snsnnd/li_ku/model/Belt_1Cell_MVP_E02/README.md

# E02 — XY同步带＋Z金属丝杆的单库位机械MVP

**使用现有3台ZDT；目标货载1kg。取消XY齿条，固定X电机，将Y电机从推拉头移到Z平台，保留金属TR8x2和金属导向。**

## 打开文件

- **[优先打开：完整纯实体兼容STEP](viewing/Belt_MVP_E02_SOLIDS_AP203.step)**，AP203、多实体零件，无运动配合。
- [彩色装配STEP](Belt_MVP_E02_ASSEMBLY.step)。若导入空白，改用上面的纯实体版；SolidWorks可按F和Ctrl+7。未在用户CAD界面中验证显示。
- [工程图PDF](drawings/同步带单库位MVP_E02_工程图.pdf)、[总装预览](previews/E02_assembly.png)、[移动结构近览](previews/E02_moving_structure.png)。预览省略保护板，完整STEP保留。
- [优化前后对比](E01_E02优化对比.md)、[打印清单](打印清单.csv)、[采购与金属加工清单](采购与金属加工清单.csv)、[采购补充与未选型项](采购补充与未选型项.md)。
- [机械设计包ZIP](同步带单库位MVP_E02_机械设计包.zip)、[交付审核](delivery_audit.json)。

## 已优化的结构

| 项目 | E02 |
|---|---|
| X | 固定电机；GT2-1000-6、20T金属带轮；不再拖动电机，移动板深度160→120 |
| Y | GT2-400-6；电机固定Z平台下方，侧置皮带，推拉头只有轻连接臂和带夹 |
| Y导向 | 双轨中心距26→52mm；局部降低6mm，皮带避开完整滑块包络及存取通道 |
| 张紧 | X向右、Y向后调整；金属带夹、带轴承惰轮及独立锁紧螺钉 |
| 承力 | 金属方管/压缩套/垫块/支板，Z金属丝杆及双螺母保持 |
| 体积 | 底板610×650→610×590×6；约616×596×523的防护外廓 |
| 功能尺寸 | X180、Z95、Y143；一货位＋独立IO＋一只原尺寸料盒 |

本版独立输出，**不覆盖E01、V03.1或手动M01**。B编号是本版分件编号，不能与E01的E编号混用。

## 1kg是不是轻载？

**就货物本身而言，是轻载。** 但它只表示货物净重；Z还要搬动托盘、导向平台、电机、释放机构和料盒。完整运动质量与扭矩估算见优化对比，不能将电机只按9.8N货物重力选型。托盘悬臂、摩擦、加减速和异常掉落也需考虑。

优化目标是减少无效移动质量、悬臂和齿条调试难度，不是把1kg包装成已验收载荷；也没有擅自提高目标承重。

货物竖向重量主要由托盘/金属方管及Z升降结构承受；Y同步带和轻连接臂负责推拉，不是把整个货物悬挂在薄连接臂上。

## 打印/采购边界

- 只打印`stl/`中`process=print`对应分件，按CSV数量；不要把整机一次打印。
- 带轮、惰轮轴承/肩轴、带夹、承力板、方管、丝杆、螺母桥和维护件必须是合适金属件，不能打印替代。
- 采购带轮/同步带是光滑有效包络，夹齿只示意节距。**它们不是GT2制造齿形，也不是已经选定供应商的产品。**
- 张紧器±/单向2mm是调整空间，不是要求把皮带拉长4mm。15N预紧只是估算例，不能作为操作张力。
- 采购BOM记录CAD实例数量，全部型材角码、PC门板保持、线束和非建模连接五金仍需补选。补充清单列出具体边界。
- 图纸是设计评审图，未完成公差、实际螺纹、厂商尺寸、有效啮合、工具可达性和工艺签审，不能直接视为加工放行图。

## 仍不能直接上电带载

同步带降低所需驱动扭矩，但张紧会增加电机轴的径向力，必须核对实际ZDT轴承/轴端能力。还需确认：

1. 实测电机质量、扭矩-转速曲线、电压/电流和温升；真实驱动带轮夹紧及轴向保持。
2. 实带规格/齿形/张力、金属带夹拉脱、惰轮轴承/肩轴、张紧锁紧、板件刚度和线束全行程。
3. 丝杆/螺母/轴承配合、预紧、横销定位套强度和寿命；全部紧固、压缩套和台面锚固。
4. **独立自动防下滑装置、实际限位/门禁/急停和电气保护，仍未完成选型/实施。** 第二螺母、低导程丝杆和手动维护销不能替代自动防坠。
5. 自动存取固件未提供；释放舵机、IO门和传感器仍需实际选型与接入。

模型维护销默认插入。Z运动前必须可靠卸载、拔销并确认状态。先完成安全措施，再组织空行程/空盒及分级加载试验；**目标1kg不等于允许直接1kg带载运行**。

## 复现

使用`cad/powered_mvp/requirements.lock.txt`中的环境；需保留归档内E01基准分件与源代码。另需可嵌入的中文字体（工具默认本机Windows SimHei）和DejaVu Sans。

```sh
python -B cad/belt_mvp/validate_belt.py --motion --export
python -B cad/belt_mvp/deliver_belt.py
PYTEST_DISABLE_PLUGIN_AUTOLOAD=1 python -B -m pytest cad/belt_mvp/test_belt.py -q -p no:cacheprovider --junitxml=model/Belt_1Cell_MVP_E02/tests.xml
python -B cad/belt_mvp/publish_belt.py
```
