snsnnd/li_ku/V03_1_先读我.md

# V03.1：承重路径与移动机构优化

**保留原 V03，独立输出到 `model/V03_1/`。这是结构优化原型，不是已经验收的整机。**

## 打开模型

- **[优先打开：轻量布局 STEP](model/V03_1/viewing/ASRS_V03_1_LIGHT_VIEW.step)**：省略防护板，简化电机和小齿轮，仅用于查看布局，不能加工或打印。
- [完整装配 STEP](model/V03_1/ASRS_Modular_V03_1.step)
- [完整细节内部结构 STEP](model/V03_1/viewing/ASRS_V03_1_INTERIOR_VIEW.step)：仅去掉防护板，仍是大文件。
- [整机预览](model/V03_1/previews/assembly_isometric.png)
- [移动模块](model/V03_1/previews/moving_module.png)
- [X 齿条支撑](model/V03_1/previews/x_rack_supports.png)
- [Z 齿条加强结构](model/V03_1/previews/z_rack_supports.png)
- [Y 取放与电源布置](model/V03_1/previews/y_module.png)
- [IO 承重结构](model/V03_1/previews/io_station.png)

轻量版和预览隐藏防护板不代表运行时可以拆除防护。橙色部件表示未选型硬件，不能照包络采购。

## 这次实际改了什么

1. **X 齿条不再悬空**：增加 7 个金属 L 形支脚，齿条背板经 M4 接支脚，支脚经 M5 接底板；接收底孔一并建模。
2. **Y 齿条补齐支撑**：将原来相隔 6 mm 的支撑块改成组合鞍座，同时连接金属脊板、承托方管和齿条背板，具有实际贴合面及配对孔位。
3. **IO 支腿落到底板**：改为带底法兰的金属支腿；顶部金属框架、料盒托板和支腿孔位对应，补齐原来 20 mm 的悬空段。
4. **Z 齿条背板加强**：铝背板由 4 mm 增至 12 mm，支撑由 2 处增至 5 处，最大支撑间距由约 525 mm 缩至 135 mm；齿条安装面、节距和啮合相位不变。
5. **减轻 Y 滑台偏载**：Y 独立电源盒移到 Z 升降平台，用本地柔性短线接 Y 电机；不再随 Y 伸缩。取放头悬臂末端由 X+256 收至 X+120，移除随 Y 的电池支腿。
6. **增加检查项**：除碰撞外，检查新增/修改接口的间隙和真实贴合面积；零件只共享一条边不算支撑。补充紧固孔和螺纹周围金属连续性回归。

料盒、20 个库位、独立 IO 位置、三轴齿条参数和真实电机模型保持原方案。

## 最终核验结果

- 34 项回归测试通过，包括真实齿形/拼接、运动相位及新增孔位检查。
- 新增/修改的 42 处接口通过名义间隙与真实贴合面积检查。
- 1097 个离散运动位姿未发现意外干涉，覆盖 20 个库位及 IO。
- 127 类零件、376 个组件；完整 STEP 回读 445 个有效实体，24 类打印 STL 通过网格检查。
- 最终文件核验错误列表为空，原 V03 CAD 的哈希未改变。

以上只表示本版几何和文件检查通过，不是实物承载、连续碰撞或运行安全认证。

## 优化收益和代价

按现有候选件质量假设，Y 刚性运动组从约 **2.05 kg 降至 1.00 kg**，绕导向中心的偏载力矩从约 **2.47 N·m 降至 0.73 N·m**，降低约 **70%**。这些数值不包含同组之外的货载，不是实测重量，也不代表导轨或螺钉已经通过承载验收。

增加支撑会增加固定结构重量；整机仍约 **68 kg 空机、90 kg 满载含余量**，不是轻量化桌面产品。最新值见 [质量与初筛报告](model/V03_1/engineering_checks.json)。

**Y 盒改挂 Z 的代价是增加一段随 Y 弯曲的本地线束。** 143 mm 行程的线束弯曲半径、应力释放和耐久尚未验证；不能把无线控制理解为没有线，也不能把未建模的柔性线束算入碰撞通过项。

## 当前仍不能放行的部分

- **Z 打印齿的承载、疲劳及蠕变未验收**。背板加强不等于齿强度合格；不能直接带 1 kg 自动运行，空载也必须先完成防坠。
- 独立防坠器/制动器仍为候选包络，没有实测动态捕获证据。
- 三轴电机曲线、减速器、金属夹紧轮毂、输出轴支承与轴向锁定仍需真实选型。**当前法兰轮毂模型不能直接当成完整夹紧轮毂制造。**
- 新增配对孔不等于已经完成螺钉长度、扭矩、工具空间及接头强度定型；T 型螺母必须匹配实际型材。
- 工作台、锚栓、安全门、限位、急停、供电和控制实机验收尚未完成。

**所有制造/硬件放行标志仍为 false。可做受控的局部手动试装，不应直接批量制造或通电带载。**

详见 [结构修改与验收说明](文档/V03_1_结构优化与验证.md)、[新增接口及运动检查](model/V03_1/validation.json)、[最终文件核验](model/V03_1/delivery_audit.json)。
