snsnnd/li_ku/同步带优化MVP_E02_先读我.md

# E02 同步带结构优化版

**三台现有ZDT；XY同步带，Z金属TR8x2；目标1kg货载保持不变。**

- **[优先打开完整兼容STEP](model/Belt_1Cell_MVP_E02/viewing/Belt_MVP_E02_SOLIDS_AP203.step)**
- [工程图PDF](model/Belt_1Cell_MVP_E02/drawings/同步带单库位MVP_E02_工程图.pdf)
- [结构预览](model/Belt_1Cell_MVP_E02/previews/E02_assembly.png)
- [E01→E02优化对比](model/Belt_1Cell_MVP_E02/E01_E02优化对比.md)
- [完整机械设计包ZIP](model/Belt_1Cell_MVP_E02/同步带单库位MVP_E02_机械设计包.zip)
- [打印、采购及安全边界](model/Belt_1Cell_MVP_E02/README.md)

X电机固定底座；Y电机固定Z平台、侧置同步带；轻推拉头、Y导轨间距加宽、底板深度减少60mm；旧E01/V03.1/M01保留。

**1kg货物算轻载，但Z还搬动平台、电机、托盘等自重。** 当前交付是机械设计及几何验证，不是加工或带载运行放行；独立防下滑、实际电气安全链、厂商尺寸/能力和控制固件仍需完成。
