snsnnd/li_ku/最小三轴验证装置_先读我.md

# 无电机手动三轴验证装置

已单独生成M01：一个原尺寸料盒、一个库位，手动X/Z/Y移动和手动插销。原V03/V03.1不改动。

- **[35页工程图PDF](model/Manual_3Axis_MVP/drawings/手动三轴验证装置_工程图_M01.pdf)**
- **[完整打印包ZIP](model/Manual_3Axis_MVP/手动三轴验证装置_M01_打印包.zip)**
- **[优先打开：纯实体兼容STEP](model/Manual_3Axis_MVP/viewing/Manual_3Axis_SOLIDS_AP203.step)**（原装配导入空白时使用，非运动装配体）
- [原装配STEP](model/Manual_3Axis_MVP/Manual_3Axis_Assembly.step)
- [打印方向、数量、五金和装配说明](model/Manual_3Axis_MVP/README.md)
- [装配预览](model/Manual_3Axis_MVP/previews/assembly.png)

**先打印C01/C03导向配合试块，再做一组齿轮齿条和单轴，别一次全部打印。** 所有打印件最大尺寸≤245 mm，但仍需检查Brim及机器有效平台。

只允许空盒手动配合验证。另需按清单准备金属螺钉、螺母、光滑隔套及Z锁销；没有电机，也不是全打印装置。不能用于1 kg承重或无人保持的升降试验。
