snsnnd/li_ku/电驱单库位MVP_先读我.md

# 带电机的单库位MVP — E01

**本版对应：现有3台ZDT电机、X/Y齿条、Z金属TR8x2丝杆、1kg目标货载。** 旧V03.1和无电机手动M01保持独立。

- **[优先打开：完整纯实体STEP](model/Powered_1Cell_MVP/viewing/Powered_MVP_E01_SOLIDS_AP203.step)**
- [工程图PDF](model/Powered_1Cell_MVP/drawings/电驱单库位MVP_E01_工程图.pdf)
- [带电机结构预览](model/Powered_1Cell_MVP/previews/E01_assembly.png)
- [打印清单](model/Powered_1Cell_MVP/打印清单.csv)及[分件STL目录](model/Powered_1Cell_MVP/stl/)
- [采购与金属加工清单](model/Powered_1Cell_MVP/采购与金属加工清单.csv)及[未选型/五金补充项](model/Powered_1Cell_MVP/采购补充与未选型项.md)
- [机械设计包ZIP](model/Powered_1Cell_MVP/电驱单库位MVP_E01_机械设计包.zip)
- [详细说明与安全边界](model/Powered_1Cell_MVP/README.md)、[交付审计](model/Powered_1Cell_MVP/delivery_audit.json)

这是机械设计评审交付，**不等于已经可自动运行、可直接加工或1kg承重验收通过**。独立防下滑、实际限位/门禁/急停、电机运行参数、连接紧固与固件仍需完成。第二螺母、维护销不能替代自动防坠。

打印仅用`stl/`内对应编号分件；禁止将金属丝杆、轮毂、螺母桥、轴承等打印替代。总装模型内维护销默认插入，运动前必须卸载并拔除。
