snsnnd/li_ku/文档/V02_工具与复现.md

# V02 辅助工具与复现

## 1. 已下载并使用的资源

- 社区Skill：<https://github.com/wzyn20051216/solidworks-automation-skill>
- 固定提交：`637846a7fa4a77657ff22e7ecc3b8c754181d27b`，MIT。
- 项目内保存于 `tools/V02/solidworks-automation-skill/`：Skill说明、许可证、装配/审查/选型说明和纯函数`drive_sizing.py`，共7个上游文件。
- `download_manifest.json`包含逐文件下载URL和SHA-256。仅下载本任务所需子集，不代表已安装上游整个CAD Studio或其所有依赖。
- 已阅读选型脚本，调用其纯函数做带加速、效率和RMS的初筛；没有运行上游自动安装器、远程会话上报或任意代码MCP。

另调研过 `hjbaard/SolidWorks-MCP`，其主体在SW2026/Y-up验证，而本机是SW2025。此次未盲目注册第三方MCP，也未改OpenCode全局配置；原生转换采用本机已有官方C# Interop，避免把未验证兼容性当成模型证据。

本地几何工具：CadQuery 2.6.1、OCCT 7.8.1、pytest 8.4.2，隔离环境 `/tmp/opencode/asrs-v02-venv/`。几何生成/检测本地运行，没有把项目CAD发给在线建模服务；本会话AI与工具自身的隐私策略仍由客户端决定，不能笼统声称“本地工具等于所有数据永不出网”。

完整已安装版本保存在`cad/v02/requirements.lock.txt`，对应CPython 3.12.13和Linux/WSL；它不是跨平台、带下载哈希的构建锁。

## 2. 生成、检查

在项目根目录，WSL/Linux：

```bash
uv venv /tmp/opencode/asrs-v02-venv
uv pip install --python /tmp/opencode/asrs-v02-venv/bin/python -r cad/v02/requirements.txt
/tmp/opencode/asrs-v02-venv/bin/python cad/v02/asrs_v02.py --validate
PYTEST_DISABLE_PLUGIN_AUTOLOAD=1 /tmp/opencode/asrs-v02-venv/bin/python -m pytest cad/v02/test_asrs_v02.py -q --junitxml=model/V02/tests.xml
/tmp/opencode/asrs-v02-venv/bin/python cad/v02/verify_motion.py --step 5
/tmp/opencode/asrs-v02-venv/bin/python cad/v02/engineering_checks.py
/tmp/opencode/asrs-v02-venv/bin/python cad/v02/render_previews.py
```

环境中有ROS的全局pytest插件，因此禁用插件自动发现；否则会把与本项目无关的ROS依赖缺失当成测试失败。

生成器仅支持已冻结的4×5版本，不提供“随便改一个列数就自动扩展所有节点”的虚假能力。变更尺寸必须同步复核连接、保护空间和全部测试。

`asrs_v02.py`会写`model/V02`中的生成产物；不是只读脚本。不会运行V01生成器，也不会覆写V01的模型、STL、说明书和验证报告。

运动采样包括名义5 mm以内的Y采样、10 mm的Z采样、15 mm的X采样、10°的销动作采样，以及另行记录间距的间隙补偿工况。它不是连续碰撞检测、接触动力学或真实电机控制。

## 3. SolidWorks 原生转换

Windows中先打开有许可证的SW2025，然后：

```powershell
D:\立库\cad\v02\ExportSolidWorksV02.ps1
# 已有native目录时必须选择新目录，不静默覆盖：
D:\立库\cad\v02\ExportSolidWorksV02.ps1 -Output D:\立库\model\V02\native_review_02
```

- 编译器为系统.NET Framework C#编译器，使用项目已有官方Interop DLL。
- 可执行文件放在`cad/ExportSolidWorksV02.exe`，与Interop位于同目录，避免运行时找不到程序集。
- 原生转换器仅导入manifest中的V02零件，检查每件单实体、包围尺寸及逐组件变换回读。
- 本机默认模板存在配置问题，会导致STEP导入失败。因此导入期间临时设置了明确的GB零件/装配模板，并暂时使用直接导入。`finally`尝试恢复原设置，但本次COM断开导致恢复失败；请按[设置确认说明](V02_SolidWorks设置确认.md)人工确认。
- 不调用`ExitApp()`，不关闭用户原有文档，也不覆盖旧原生输出目录。
- 原生部件被固定以保存审核姿态。**没有建立真实运动配合、没有保存已验收的Motion Study，不把脚本位姿采样冒充它们。**
- 失败尝试保留于独立诊断目录；只有`solidworks_validation.json`明确成功，才可称该次原生输出完成。

## 4. 验证证据

后续审查先运行`cad/v02/audit_delivery.py`，检查模型、脚本、验证报告、STEP回读、STL封闭性和原生报告指纹。

制造放行另依赖`V02_安全与验收.md`，不能用软件测试通过替代硬件、安全接线和实机试验。

## 本次原生转换的实际状态

STEP导入在第54件方管处长时间停留。已保存53件原生零件，但未组成完整原生装配。取消后收到`0x800706BE`，不把这些部分产物算作完整原生交付。

用户明确选择保留SolidWorks、先交付STEP，因此未重启或强制结束SolidWorks，也不再尝试新会话。若COM断开导致设置恢复失败，应按原生报告检查默认模板及3D Interconnect选项。

已准备带指纹验证的`-ResumeVerified`续作分支和方管官方Modeler建模分支，以避免重复信任旧文件和再次卡在同一STEP导入；**该续作分支只做编译检查，尚未在本次会话真机验收**。需要SolidWorks恢复可用、确认文档无未保存风险后再执行，不能把其存在当成已完成原生转换。
