snsnnd/li_ku/文档/V02_结构优化与交付说明.md

# V02 结构优化与交付说明

日期：2026-11-04。保留 V01，新增 `cad/v02/`、`model/V02/`、`tools/V02/`。

## 先读结论

V02 已建立可计算、可复核的台式立库**工程原型结构**：4 列×5 层、单箱 1 kg，统一了 XYZ、取放器、支承和连接基准。它不是“所有零件摆进去就完成”的外观模型。

**制造放行仍为 BLOCKED。** 采购件真实图纸、完整制造工程图、紧固件/工具空间复核、冲击防坠试验、电气安全回路和实机验收没有完成。几何检查通过不等于这些项目通过，不得据此直接批量加工或无人值守运行。

本版主动放宽了 V01 外廓，不是等体积替换：

| 项目 | V01 | V02 冻结基线 |
|---|---|---|
| 库位 | 4×5 | 4×5 |
| 列中心 X | 70、210、350、490 | 75、225、375、525 mm |
| 承托面 Z | 94～434，层距85 | 200、295、390、485、580 mm |
| 整机含防护包围 | 640×390×550 | 786×546×769 mm |
| 料箱箱体 | 110×120×60 | 110×120×60 mm；含牵引耳进深136 mm |
| 主承托臂 | PETG 包络 | 两根 6061 方管25×25×2，长227 mm |
| 估计质量 | 未完整统计 | 空机CAD/目录估计约43.6 kg；含20 kg货载和2 kg附件余量约65.6 kg |

**这是工作台级、有防护的结构版本，不适合直接放在普通办公桌上。** 质量含采购件包络/目录假设和打印件实心上界，不是称重。工作台承载建议以至少100 kg为采购初筛，并另核实四点M6锚固和桌板抗拔能力。若体积、重量或成本必须接近 V01，应先确认这些硬约束，再做轻量化，不应默默删去防护或减薄承力件。

## 1. 交付文件

| 路径 | 内容与边界 |
|---|---|
| `model/V02/ASRS_Modular_V02.step` | 有组件名和颜色的整机装配，权威交换模型 |
| `model/V02/parts/` | 单零件 STEP；实际有效清单以 manifest 为准 |
| `model/V02/stl/` | 当前十类打印件；不可打印采购件包络 |
| `model/V02/manifest.json` | 零件、数量、材料用途、局部坐标、运动组和生成器SHA-256 |
| `model/V02/holes.csv` | 建模孔的轴线、切除直径和切除范围；不是完整加工工艺卡 |
| `model/V02/BOM.csv` | 已建模物料，不含全部螺钉、导线和电气件 |
| `model/V02/Cell_Coordinates.csv` | 新版20个库位坐标，不能继续用V01坐标 |
| `model/V02/validation.json` | 名义尺寸链、全装配静态实体干涉及逐对接触例外 |
| `model/V02/motion_validation.json` | 实体运动采样；包括料箱不随已释放取放头运动的工况 |
| `model/V02/engineering_checks.json` | 逐项质量、选型初筛、方管、丝杆及备用螺母冲击估算 |
| `model/V02/tests.xml` | 回归测试结果 |
| `model/V02/previews/` | 从真实CAD网格生成的前、侧、等轴测和取放器检查图 |
| `model/V02/native/` | 原生转换的结果和独立报告，以其中状态为准；失败不能称已交付原生装配 |
| `文档/V02_安全与验收.md` | 安全设计、失效模式、采购冻结和实机放行清单 |
| `文档/V02_工具与复现.md` | 辅助工具来源、权限边界和复现命令 |

模型由代码参数生成 B-rep，不是完整草图/尺寸/特征历史。SolidWorks 原生转换即使成功，也是**导入实体＋定位装配**，不是已经建立运动配合和 Motion Study 的数字样机。预览图为检查内部而隐藏防护板，并不表示实际运行允许拆除防护。

## 2. 总体传动方案

### X：双MGN12、四滑块、GT2同步带

- 两根700 mm导轨，中心Y=-285/-215。MGN12H以总装配高度13 mm建模，不再叠加为21 mm。
- 同轨滑块中心距80 mm，相邻端部净距34.6 mm，消除原先1 mm重叠。
- 导轨直接安装到700×30×24金属基准条，M3攻丝孔与导轨孔同向同节距；基准条以低头M5连接底板。
- X电机倒装在底板上方，没有电机本体穿到桌面以下的情况。电机座、支腿、底板的长螺栓孔及装配顺序已表达。
- 两个20T带轮中心距690 mm，理论节线带长1420 mm，带宽6 mm。购买定长带或在另行复核夹具后采用开口带，不能把光滑包络STL当GT2齿形。
- 从动座有四个10×5.5长孔和M4顶丝张紧器，约±2.25 mm调节。张紧后先锁座，再锁顶丝螺母。

### Z：TR8×2金属丝杆、四MGN12H滑块、独立导向

- 双3030立柱，前侧双500 mm整导轨，每轨两块MGN12H。
- 导轨Z=85～585，最低/最高层的滑块端距分别13.3/11.3 mm。
- 最低层Z滑台板与X滑台板净高差45 mm，不再发生原先最低层撞板。
- 立柱底部以M8端部连接及前后M6角座承受倾覆力矩；角座顶面低于导轨起点2 mm。
- 工作螺母安装在钢连接桥上。丝杆只传轴向驱动力，偏心力矩由两轨四滑块承担。
- 固定端有径向626、钢台阶垫圈、双F6-12M推力轴承、正向定位环、端盖及吊座；下端径向支承允许轴向浮动。
- 轴向定位环用2.5 mm匹配横销形成正向连接，**不只靠小轴环的摩擦夹紧承受备用捕获冲击**。横孔、材料和热处理必须发给丝杆供应商确认，不允许在未经核实的普通丝杆上自行钻孔后直接运行。
- 电机指定失电制动型，静态制动力矩初筛≥0.3 N·m。不把TR8×2自锁当成唯一安全措施。

### Y：MGN9H、200 mm整轨、143 mm箱体位移

- 导轨放在托盘下方，不穿Z滑台板。MGN9H采用39.9 mm长度、10 mm总高度、15×16 mm安装孔距。
- 导轨Y=-225～-25；夹带座与支承块内侧保持避让，轴端有机械挡块。
- 两轮中心距182 mm，理论带长404 mm。后轮有三组长孔、金属滑动座和M3张紧顶丝，约±1.5 mm调整。
- 固定取放器和托盘前后位置同时考虑了货架牵引耳外凸。满载升降时，不把牵引耳当作不存在。
- 料箱从Y=-78移动到65，名义箱体位移143 mm。托盘后沿为-13，格口前沿为0，跨越间隙13 mm；箱底120 mm深，交接时仍有连续的两侧底部支承。

## 3. 末端机构：可打印机构不只是支架

V02采用“水平牵引耳＋竖直钢销＋舵机曲柄滑槽机构”：

1. 料箱前部有32 mm宽、6 mm厚的水平牵引耳，孔Ø6.2，孔中心位于箱体中心Y-68、底面以上10～16 mm。
2. Ø4钢销带导入锥，穿入孔后拖动料箱，不承担料箱重力。
3. 钢销经过上下两只可换衬套，两只金属轴环夹住打印滑槽件；打印曲柄通过钢滚销驱动滑槽。
4. 曲柄半径7 mm，理论全行程14 mm。推荐初调15°～165°，实际行程约13.52 mm，避免用舵机机械极限硬顶。
5. 上导向与轴环之间有金属回位弹簧，断电倾向于落销，但仍需到位反馈和实机断电测试。
6. 舵机有连接到金属立板的打印托架和压盖，不再悬空。花键接口仍必须按选购舵机真实图纸匹配。
7. 托盘有40 mm前开口通槽和后部连桥，避开贯穿的取放立板；不能在旧实心托盘上只补一个小孔。

打印件采用PETG，料箱开口朝上；承力臂、钢销、螺母、轴承及防坠捕获件不打印。打印件均以当前manifest核实单件不超过A1的256 mm范围。

### 销孔间隙必须计入实际动作

Ø6.2孔与Ø4销有单边1.1 mm余量。名义箱体行程143 mm，不等于实际换向后电机只走143 mm就一定到位。

- 向货架推送，吃隙后可表示为：`pin_q = box_q + 1.1`。
- 从货架拉回，接触另一侧后可表示为：`pin_q = box_q - 1.1`。
- 端到端指令范围约145.2 mm；实际数值应逐箱标定，不能把打印孔径当精密孔。
- 间隙补偿后导轨最小端距约6.95 mm，机械挡块最小剩余间隙约2.95 mm；仍需与实物端封、螺钉头、公差叠加复核。
- 格口/托盘导向内宽111.2 mm，控制箱体横向浮动约±0.6 mm，而不是任其在118 mm内自由横移。

运动检查区分“销已释放，料箱留在库位”和“销已啮合，料箱被拖动”，并补充推、拉两种间隙补偿姿态。**这仍不是实际摩擦、碰撞和柔性接触仿真。**

## 4. 主受力路径与连接要求

| 路径 | 实际设计 |
|---|---|
| 存储箱体→货架 | 打印底托→左右金属L形托角→前后立柱→金属底脚/垫座→连续底板→工作台 |
| 搬运箱体→Z导向 | 托盘两侧承重翼→两根铝方管→金属端塞/横向锁定螺钉→Z板→四滑块/双轨→双立柱→X板 |
| Z升降驱动力 | 箱体及附件→钢连接桥→铜螺母→金属丝杆→推力轴承/正向横销→顶板→立柱→X板 |
| 整机抗侧摆 | 后部金属抗剪板→十处间隔连接→前后立柱与底板；不能靠打印定位键抗整机侧向力 |

关键装配细节：

- MGN滑块连接板做沉孔，避免螺钉头被立柱压住或碰到Y机构。以M3×8和实际滑块最大旋入深度复核，不能任意换长螺钉。
- 托盘方管顶面位于料箱底面以下4 mm，没有承托臂侵入箱底。方管穿透螺钉需要金属抗压套，不能把中空薄壁管直接压瘪。
- 托角与底托孔位、导轨与基准条孔位、舵机支座与立板孔位有对应关系；`holes.csv`提供建模坐标，但旋向、攻丝、公差及装配工具仍需工程图确认。
- 型材是保守外形/中心孔模型，没有伪称其T槽截面和槽螺母已经完成供应商级验证。
- 通用紧固件并未全部绘成实体，且硬件BOM有未建模补充项。现有零干涉结果**不覆盖所有螺钉头、螺母和扳手空间**。

## 5. 选型初筛，不用保持力矩冒充运行能力

按实体体积、目录重量和明确的附件余量重新统计：Z设计运动质量约3.51 kg，X约8.00 kg。

| 轴 | 初始限速 | 初始加速度 | 需求转速 | 含2倍系数的初筛转矩 |
|---|---:|---:|---:|---:|
| X | 50 mm/s | 100 mm/s² | 75 rpm | 约0.081 N·m |
| Z | 8 mm/s | 30 mm/s² | 240 rpm | 约0.102 N·m |
| Y | 20 mm/s | 50 mm/s² | 30 rpm | 约0.127 N·m |

这些是带假设的选型需求，不是电机已通过。必须拿到对应驱动电压、电流、温度下的转矩—转速曲线。Z效率按0.25初筛；摩擦、转子惯量及线缆阻力有明确假设，返回/制动效率、丝杆临界转速、寿命仍未完成验证。

两根25×25×2铝方管的理想悬臂初筛：2倍载荷系数下，弯曲应力约2.05 MPa、挠度约0.037 mm。**该值不含螺栓连接、打印托盘和导轨安装面的柔度，不能当成整机定位精度。**

备用螺母0.8 mm捕获间隙可能产生远高于静载的冲击。按假定0.05 mm停止变形估算，峰值约1.17 kN，故另设1.2 kN捕获工况，而不是只计算几十牛静载。横销、横孔轴、轴承、钢笼、四个M3连接和安装桥必须一起审查及试验。

## 6. 当前验证如何阅读

- `validation.json`：当前整机静态检查；仅允许两对明确的夹带接触，不按运动组大范围忽略干涉。
- `motion_validation.json`：20个库位，取放、已释放伸出/退回、横移、升降、销抬升、推/拉间隙补偿；采样间距和数量在报告中逐项给出。
- `tests.xml`：覆盖旧版低层碰撞回归、短导轨不被误判通过、孔配合、打印范围、横向导向、备用螺母间隙和正向横销。
- 报告含生成器指纹；运动报告另含检查脚本指纹。指纹不匹配的旧报告不能作为当前模型证据。
- 供应件的滚道、皮带齿、丝杆螺纹和弹簧线圈采用明确标注的包络；采购接口、柔性、电气和实机性能仍需验证。

## 7. 关于“能否直接3D打印传动”

可以，传动并不局限于丝杆/皮带：

| 方式 | 对本项目的判断 |
|---|---|
| 打印曲柄、滑槽、轻载凸轮/连杆 | V02已采用，用于抬销；配钢销、衬套和可更换磨损件 |
| 打印齿条/齿轮驱动X或Y | 可做下一轮候选，但需齿形、齿根、背隙、拼接相位及磨损试验；不能随便用方齿示意模型制造 |
| 打印丝杆/螺母 | 适合小载荷演示，不作为本版Z轴长期承重方案 |
| 打印蜗轮或自锁机构 | 不能仅因名为“蜗轮”就认为可靠自锁；PETG蠕变和磨损仍在 |
| 全打印立库承力和防坠 | 不建议作为1 kg箱体、无人值守系统的首版落地路线 |

本版不是只换成更贵的金属件：将3D打印用于可替换、轻载且易试验的实际机构，将承重和安全闭环留给可追溯金属件。未经用户确认，不采购硬件、不连接真实控制器运行。
