snsnnd/li_ku/文档/V03_1_结构优化与验证.md

# V03.1 结构优化与验证说明

## 1. 范围及保留内容

本版针对 V03 检查发现的悬空连接、Z 齿条背板柔度和 Y 随动偏载进行局部修改。新增生成器位于 `cad/v03_1/`，依赖冻结的 V03/V02 几何工具，不改写 V03 源码、CAD 或报告。

保留：4 列×5 层、单箱 1 kg 的设计输入；料盒/牵引销接口；X/Z 行程和独立 IO 位置；模数 1.5、20°压力角、20 齿小齿轮、每段 24 齿距（113.0973355 mm）；用户提供的完整电机参考模型。1 kg 是输入目标，不是经过认证的运行载荷。

## 2. 新增承重和反力路径

### X 齿条

- 在 X=-210/-60/90/240/390/540/750 mm 设置金属 L 形支脚。
- 支脚底面贴底板上表面 Z=6 mm，竖板贴齿条背板后表面 Y=-328 mm。
- 背板与每个支脚用 4 个 M4；支脚底部有 4 个 M5 长孔，底板有对应 Ø4.2 攻丝导孔。
- X=390 的支脚跨底板接缝，分别连接两侧底板，不能把它只固定在一侧。
- 长孔提供名义 ±1 mm 的 Y 向安装调整量。**这不是允许带载运行的啮合误差范围**；只有中性装配位置经过当前齿形检查。实装应整条校直，用啮合试块确定背隙后统一锁紧，禁止各段独立乱调。

### Z 齿条

- 铝背板厚度 12 mm，宽 30 mm、长 566 mm，向背面加厚以保留原齿条安装面。
- 支撑位于 Z=100/230/360/490/625 mm，最大间距 135 mm。
- 每个支撑两颗 M3 固定背板，另一端一颗 M5 对应左侧 3030 后槽中心。五个支撑共同约束，实际槽形和 T 型螺母必须按供应商图纸复核。
- 约 29 N 横向分离力下，孤立背板的理想简支梁初筛挠度约 0.005 mm。**这个数字只描述理想金属梁，未包含接头、支撑、型材、齿条、装配误差，不能宣传为整机定位精度或实测变形。**
- Z 打印齿按原 Lewis 简化模型计入两倍系数后，仍约 29 MPa；不能凭背板刚度改善就解除打印齿和独立防坠验收要求。

### Y 齿条和取放头

- 两个组合鞍座位于 Y=-217/-25 mm，替代原齿条支撑和右侧方管间隔块。
- 底面贴脊板，顶面支承方管，外侧台阶托住齿条背板；侧面 M3 孔固定背板，M4 固定脊板和方管。
- 方管紧固仍须金属压套，不允许靠拧紧螺钉压瘪薄壁方管。
- 保留取放头与 Y 电机随 Y 运动，缩短不再需要的电池外伸板；电机减速器和轮毂真实接口未因此自动选型完成。

### Y 独立电源改挂 Z

- 专用 Y 电源盒转 90°，中心约为 X=搬运中心+175、Y=-135、Z=层面-20 mm。
- 通过阶梯金属支架固定在 Z 滑板右侧，不再连接 Y 滑块。与 Y 取放头之间新增柔性短线要求。
- 支架侧向 M4 螺纹孔避开原 Z 滑块安装沉孔，位于层面-63/-53 mm；回归检查螺纹周围的连续金属。
- 托板支架的 M4 螺钉须选实际低头型并嵌平，不能让螺钉头顶住电源盒底面。
- 同组质量估算从 2.046 kg 降至 1.003 kg；横向偏载力矩从 2.469 降至 0.728 N·m。理想两轨反力从约 -85/+105 N 改善到 -23/+33 N，仍有上拔约束，仍须核对滑块和紧固件额定能力。
- 线束弯曲半径、固定点、应力释放、最短/最长姿态、插头保持和寿命必须实物确认。当前报告不验证柔性线束碰撞和疲劳。

### IO 及底座

- 法兰支腿从底板 Z=6 mm 支撑到框架下表面 Z=190 mm，金属框架顶面 Z=196 mm 对应打印托板底面。
- 每腿四颗 M5 固定底法兰，一颗 M5 将框架固定到腿顶部；料盒托板四颗 M4 与金属框架位置对应。
- 底板额外预留四个 Ø8.5 工作台锚固孔；工作台和锚固能力仍需按实际台面材料、跨度、边距及载荷设计。应在平整且有连续可靠支撑的专用台面上装配，不能只支撑分块底板的四个外角。

## 3. 证据分别说明什么

### 质量与驱动初筛对比

| 项目 | V03 | V03.1 |
|---|---:|---:|
| 空机估算 | 67.06 kg | 67.80 kg |
| X 搬运质量，含货载/余量 | 13.41 kg | 13.69 kg |
| Z 升降质量，含货载/余量 | 7.33 kg | 7.17 kg |
| Y 运动质量，含货载/余量 | 3.41 kg | 2.36 kg |
| X 电机需求，含两倍系数 | 0.318 N·m | 0.322 N·m |
| Z 电机需求，含两倍系数 | 0.343 N·m | 0.336 N·m |
| Y 电机需求，含两倍系数 | 0.225 N·m | 0.174 N·m |

仍沿用 X/Z/Y 候选研究速度 12/3/5 mm/s、Z 10:1 与 Y 3:1 减速及假设效率；这些是选型需求而非现有电机已通过的证明。Y 电源移到 Z 并没有消除其重量，只是避免它再经过窄小的 Y 滑块和悬臂。固定支撑加强略增总重，不能宣传整机减重。

| 文件 | 证明范围 | 不代表 |
|---|---|---|
| `validation.json` | 新增接口的间隙与平面贴合面积、静态干涉、离散运动采样 | 螺钉强度、连续碰撞、接触动力学 |
| `engineering_checks.json` | 假设质量、转矩需求、理想梁和打印齿初筛 | 实际电机曲线、有限元、承载认证 |
| `tests.xml` | 真实齿形/接缝/轴相位、库位、销机构、视觉视线及新结构回归 | 实物寿命、无线或视觉实机成功 |
| `delivery_audit.json` | 输出 STEP 回读、STL 封闭性、报告指纹、原 V03 CAD 未变 | 整机制造或运行放行 |
| `viewing/light_view_readback.json` | 简化布局 STEP 有效性 | 可加工或可打印模型 |

连接检查对新增/修改的 42 处接口要求零名义间隙且有大于 2 mm² 的真实平面接触。这个下限只用于排除悬空、点/线接触，不是允许接触应力或最小承载面积的设计值。未修改的全部原始接头不在这 42 项的完整紧固认证范围内。

运动采样覆盖全部 20 个库位、IO、取放、抬销后撤回、销孔间隙补偿、X 各层横移、Z 各列升降及内门行程。使用包含后驱动板的保守电机包络；小齿轮旋转外包络与真实齿形分别检查。不允许据此擅自启用同时三轴运动。

## 4. 仍需完成的实物验收

1. 一段打印齿条、小齿轮和真正夹紧轮毂的手动试装：接缝、中心距、磨损、拉脱及重复定位。
2. 采购电机/减速器/轮毂/轴承：实际质量、转矩曲线、输出悬臂载荷、背隙和轴向保持。
3. Z 独立防坠：断齿但电机仍有电、断电、低电压、控制死机和传感器故障均须覆盖，证明动态捕获，不只证明静态抱闸。
4. 新增支架试制：孔位、螺钉头、旋入深度、工具空间、T 型螺母、防松、焊缝/加工方式及偏载。
5. Y 柔性线束、电池/BMS/供电、安全链、门联锁和限位。
6. 经有能力的机械工程人员复核并完成受控试验后，才讨论逐级加载和自动运行；不得直接跳到满载。

## 5. 复现

在项目根目录运行，输出只进入 `model/V03_1/`：

```bash
uv venv /tmp/opencode/asrs-v03-1-venv --python 3.12
uv pip install --python /tmp/opencode/asrs-v03-1-venv/bin/python -r cad/v03_1/requirements.txt
/tmp/opencode/asrs-v03-1-venv/bin/python -B cad/v03_1/asrs_v03_1.py --export
PYTEST_DISABLE_PLUGIN_AUTOLOAD=1 /tmp/opencode/asrs-v03-1-venv/bin/python -B -m pytest cad/v03_1/test_v03_1.py -q -p no:cacheprovider --junitxml=model/V03_1/tests.xml
/tmp/opencode/asrs-v03-1-venv/bin/python -B cad/v03_1/validate_v03_1.py --motion --step 12
/tmp/opencode/asrs-v03-1-venv/bin/python -B cad/v03_1/export_views.py
/tmp/opencode/asrs-v03-1-venv/bin/python -B cad/v03_1/audit_v03_1.py
```

本版没有生成带运动配合的原生 SolidWorks SLDASM；STEP 为代码参数化实体装配。制造图、配合公差和实物安全回路尚未发布。
