snsnnd/li_ku/文档/结构设计说明书.md

# 桌面级立库结构设计说明书（V01）

> 坐标系：X 向右（列方向），Y 向货架内侧（取放伸出方向为正），Z 向上。原点位于货架前左底部。
> 单位：mm。基准方案 4 列 × 5 层 = 20 个库位。整机包围尺寸 640 × 390 × 550。
> 本版为**结构基准版**：几何尺寸、装配关系、打印件网格已校验；电机控制与实机取放**尚未验收**，见第 8 节。

## 1. 设计原则

1. **料箱底面承重，拨钩只负责拖动**。取放器不夹持、不吊挂料箱，避免打印件受弯。
2. **可插拔优先**。套件、格口托轨、驱动座、从动座、末端拨钩均为独立模块，定位键/销负责精度，M5/M4 螺栓负责锁紧。
3. **运动长导轨不拼接**。货架可分段扩展，但 X/Z 导轨必须整根更换，禁止接缝。
4. 打印件全部适配拓竹 A1（256 × 256 × 256）单件打印，最长件 143 mm。

## 2. 参考图结构解读

参考视频里的取放并非夹爪：料箱前壁带一个**外凸框形扣口**，末端是一根**可伸缩拨钩**，钩住扣口把料箱从格口拖到承托平台；料箱重量始终由平台/格口承担。本设计保留这个原理，并补充：

- 扣口改为封闭框形（44 × 16 外廓，36 × 8 净开口），避免开口钩在料箱偏移时脱出；
- 拨钩截面 30 × 20，钩舌高 10，只在扣口内摆动，不穿过料箱前壁；
- 承托盘中间留 12 mm 通槽，拨钩可退回槽内，料箱落位后不被钩住。

## 3. 整机模块划分

| 模块 | 组成 | 可更换方式 | 扩展方式 |
|---|---|---|---|
| 底座框架 | 2020 型材 X600 ×4、Y370 ×2、锚固板 ×2 | 整段拆装 | 加长 X/Y 型材 |
| 货架单元 | 立柱 Z510、横梁 X120、进深梁 Y130、格口托轨 | 单列独立拆装 | 每列 +1 立柱 +2 横梁 +1 进深梁 |
| X 轴 | 双 MGN12 导轨（600）、4 个滑块、滑台板、NEMA17、端部座 ×2 | 驱动座/从动座独立 | 换更长整根导轨与同步带 |
| Z 轴 | 双 2020 立柱（480）、双 MGN12（450）、2 滑块、滑台板、NEMA17 | 整个 Z 模块可拆 | 换更长立柱/导轨 |
| Y 轴 | MGN9（170）、滑块、拨钩、SG90、NEMA17 | 末端总成可换 | 加长导轨与带 |
| 料箱 | 110 × 120 × 60，壁厚 2.4，框形扣口 | 单体替换 | 不改骨架即可换规格（需同步改格口） |

## 4. 关键接口尺寸

### 4.1 料箱与拨钩

- 料箱外廓 110 × 120 × 60，壁厚 2.4，底部厚 2.4。
- 扣口：外框 44 × 16，净开口 36 × 8，位于前壁 Z = 36~52，向 −Y 外凸 12。
- 拨钩：总宽 30、总深 20、总高 28；钩舌 30 × 4 × 10；转轴孔 Ø3.2（沿 X）。
- 配合余量：净开口 36 对钩宽 30，左右各 3 mm；钩舌高 10 对开口高 8，需靠伺服抬升进入，**不允许带载硬撞**。

### 4.2 格口托轨（Rack_Cell）

- 托板 118 × 130 × 4，中心与库位对齐。
- 两侧导向条 3 × 130 × 8，位于 X = ±57.5，顶面高 11.5。
- 两个 T 槽插块 6 × 12 × 6，位于 X = ±61；各开 Ø5.5 通孔，配 M5 × 16 螺栓锁入 2020 型材。
- 定位方式：插块先卡入型材槽，再单点锁紧；更换格口不需要拆横梁。

### 4.3 承托盘与承托臂

- 托盘 118 × 130 × 4，中间 12 mm 通槽，两侧导向条同格口。
- 承托臂 12 × 96 × 8，两根，分别接 Z 滑台板与托盘，解决悬臂支撑。
- 托盘面与格口面同高（库位层高 85，净空 60 + 25 余量）。

### 4.4 运动轴安装面

- X 导轨中心 Y = −200 / −150，导轨面 Z = 40；滑块面 Z = 53；滑台板 Z = 61。
- Z 立柱 X = 库位中心 ±25，Y = −180；导轨 Y = −166；滑块面 Y = −156。
- Y 导轨 Y = −71，滑块面 Z = 库位面 −10；拨钩中心 Y = −137，位于库位前沿之外。
- 驱动端/从动端：`Keyed_Bracket_60x30` 两块定位键（4 × 8 × 4）+ 两个 Ø5.5 孔，间距 44，可整体拆下换电机或带轮。

## 5. 库位坐标

格口顶面 Z = 94 + 85 × (层 − 1)；料箱中心 X = 70 + 140 × (列 − 1)，Y = 65。
完整表见 `model/Cell_Coordinates.csv`。

| 层 | 1 | 2 | 3 | 4 | 5 |
|---|---|---|---|---|---|
| 顶面 Z | 94 | 179 | 264 | 349 | 434 |

## 6. 运动行程与控制建议

| 轴 | 有效行程 | 建议回零 | 传动建议 | 步/毫米（1/16 细分） |
|---|---|---|---|---|
| X | 420（70~490） | 左端 −10 附近 | GT2 20T + 同步带 | 80 |
| Z | 340（94~434） | 最低层下方 | T8 导程 8 丝杆或 1:2 带减速 | 400（丝杆） |
| Y | 钩行 137 到扣口；料箱位移 130 | 退回 −137 | GT2 20T + 同步带 | 80 |
| 拨钩 | 0 / 抬升 ~35° | 收回 | SG90 或 28BYJ 减速 | — |

> 步/毫米按 200 步/转、1/16 细分计算；实际必须用 100 mm 指令实测标定，不得直接采信。

## 7. 静载力矩估算（非实测）

输入假设：料箱 PETG 净重 125.6 g（由 STL 体积 98.94 cm³ × 1.27 g/cm³ 计算），有效载荷 1.0 kg，摩擦系数 0.30。

| 项目 | 结果 |
|---|---|
| 运动质量 | 1.126 kg（不含托盘/滑座） |
| Y 拖动阻力 | 3.31 N |
| Y 带轮力矩（r = 6.37） | 0.0211 N·m |
| Z 提升力（含 20% 附件余量） | 13.3 N |
| Z 同步带力矩 | 0.0844 N·m |
| Z T8 丝杆力矩（效率 0.5） | 0.0337 N·m |

42 步进电机（假定 0.4 N·m 保持力矩）在**静态**上有 5~19 倍余量，但该结论不含加速、同步带回差、丝杆效率波动与安全系数。**这是估算，不是实测**。

## 8. 当前验证状态（必须如实阅读）

| 项目 | 状态 | 证据 |
|---|---|---|
| 装配完整性 | 通过 | 96 个组件、包围 640 × 390 × 550，`CAD_VALIDATION_OK` |
| 组件位置/旋转 | 通过 | 96 个组件 Z ≥ 0 且旋转矩阵为单位阵 |
| 打印件封闭性 | 通过 | 5 个 STL 均 watertight、单一实体、法线一致 |
| A1 打印范围 | 通过 | 最大包络 143 mm < 256 mm |
| 库位/行程一致性 | 通过 | 20 库位、X 420、Z 340、Y 钩行 137 / 箱移 130 |
| 电机驱动取放 | **未验证** | 本机只检测到 COM8/COM13 虚拟串口，无实体控制器 |
| 实机负载/重复定位 | **未验证** | 未装配、未接线 |
| 螺栓孔/干涉细查 | **未完成** | 板类零件目前为包络实体，无孔位与倒角 |

### 已知待修正项（V02）

1. `X_Carriage_Plate`、`Z_Carriage_Plate`、`Z_Cross_Plate` 仍是包络方块，必须补 M5 螺栓孔、定位止口与沉头孔。
2. 拨钩与 SG90 之间只有包络关系，需补连杆/摇臂实体并确定死区角度。
3. 型材端部未做 45° 切口或端盖，实际装配需加连接件与端盖。
4. 未做全零件干涉检查；首次试装应以实物测量为准。
5. `Tray_Arm_12x96` 目前是实心包络，实际打印建议 4 层墙、30% 填充并开减轻槽。

## 9. 装配顺序

1. 底座：两根 Y370 与四根 X600 用角件连接，锁 `Keyed_Bracket` 锚固板。
2. 货架：先立 5 根立柱与 5 根进深梁，再装 8 根横梁；每装一列立即用格口插块校正列距 140。
3. 格口：从下往上装 20 个格口托轨，单点 M5 锁紧，装完用 118 宽样件通规。
4. X 轴：整根导轨对中后锁端部座，装 4 滑块与滑台板，手动全程推拉无卡点。
5. Z 轴：立柱与导轨整体预装，再通过 2 块定位连接板挂到 X 滑台。
6. Y 轴与末端：先装导轨与滑座，再装承托臂、托盘、拨钩与伺服，最后放料箱。
7. 电气：先单轴空载，再联调，最后带箱。

## 10. 实机验收清单（接线后逐项打勾）

| # | 测试 | 通过标准 | 记录 |
|---|---|---|---|
| 1 | 断电手动推拉 X/Z/Y | 全程无卡涩、无金属刮擦 | 待填 |
| 2 | 料箱过扣口 | 拨钩能进出，料箱不刮前壁 | 待填 |
| 3 | 单轴 100 mm 标定 | 实测误差 ≤ 1 mm | 待填 |
| 4 | 限位/回零 | 三次回零位置一致，偏差 ≤ 0.5 mm | 待填 |
| 5 | 空载取放循环 ×10 | 不掉箱、不撞格口 | 待填 |
| 6 | 加载 1 kg 取放 ×10 | 拨钩不打滑，Z 不掉步 | 待填 |
| 7 | 30 min 连续运行 | 驱动器与电机外壳 ≤ 60 ℃ | 待填 |
| 8 | 重复定位 | 同一库位 10 次，偏差 ≤ 1 mm | 待填 |

> 未完成 1~8 项前，不得对外称“系统已可用”，只能称“结构基准版已完成”。

## 11. 文件索引

| 内容 | 路径 |
|---|---|
| 整机装配 | `model/ASRS_Modular_V01.SLDASM` |
| 取放模块 | `model/Pickup_Module_V01.SLDASM` |
| 整机 STEP | `model/ASRS_Modular_V01.STEP` |
| 零件 | `model/*.SLDPRT` |
| 打印件 | `stl/*.STL` |
| 库位坐标 | `model/Cell_Coordinates.csv` |
| 校核结果 | `验证报告.json` |
| 零件参数 | `文档/零件参数表.csv` |
| API 封装 | `文档/SolidWorks_API封装说明.md` |
