snsnnd/li_ku/model/CoreXY_Final_C04/采购补充与未完成项.md

# C04 采购与验收边界

`采购与金属加工清单.csv` 是模型数量及加工/采购分类，不是已确认可下单的供应商 BOM。所有金属承力件、货叉、丝杆/螺母、肩轴、轴承和导轨都禁止用打印件替代。

| 项目 | 当前定义 | 下单/装配前必须完成 |
|---|---|---|
| 3 台已有 ZDT 电机 | 采用用户 STEP 的完整 24 实体几何 | 实测重量、驱动接口、供电/电流、运行曲线及温升；轴承径向额定值 |
| 4 组带端夹 | Phidgets TRM4226_0 / GT2M-06 齿板+背板，18×18.8×4，10×9.4 孔网 | 向厂家确认齿板/背板供货组合、真实带厚和匹配；夹紧及拉脱/耐久试验 |
| 2 条开口带 | 2GT / 6 mm，玻纤增强；几何路径含两端夹持尾段 | 确认工作拉力、实际裁切和装配余量；测量预紧；0..2 mm 滑槽不是张力值 |
| 2 个驱动轮 | 金属 GT2 / 20T / 6 mm，孔 Ø5，下置分体夹紧轮毂 Ø16×6 | 采购精确图纸符合性；M3 夹紧与实测滑转扭矩；不得据无齿包络切齿 |
| 惰轮与肩轴 | 双层路径、轴承内圈隔套/垫片、定制 D5 肩轴 | 完整厂家轴承/轮尺寸、轴肩圆角/配合、预载、锁紧和额定承载审核 |
| 张紧与锁紧 | 左端 M3×25 调节，M3 槽锁紧，M2×12 压板连接 | 螺纹公差/材料、沉孔头型和扳手通道；实际紧固扭矩、防松与循环验证 |
| 横梁连接 | 8 颗 M4×10 向上；端板 Ø4.2 通孔/Ø8 凹位，梁壁 Ø3.3 底孔 | 梁底壁加工为 M4 螺纹；名义 4 mm 啮合的强度与装配检验；不得误用 X=0 的无孔位置 |
| Z 升降及叉架 | TR8x2 金属丝杆、金属双螺母、推力栈和固定钢叉 | 实际螺母/轴承/联轴器符合性；连接强度/间隙；独立自动防坠 |
| 机架/双轨/门/底座 | 以分件 STEP、孔表及总装定位为准 | 全部连接与紧固、共面/平行度、工具通道、焊接/锚固及公差签核 |

## 不包含在“几何通过”里的安全项目

- 断电或故障自动防下滑方案尚未选定；不能以低导程自锁、第二螺母或手动维护销替代。
- 未交付可运行的 A/B 同步固件、驱动配置、急停/断能、限位/门禁电路和线束设计。
- 未完成制造签核、空载/空盒、分级加载或耐久验收；1 kg 仅为设计输入。
- 透明防护几何不是已验收的机械隔离措施；IO 开门顶部名义余量仅 6 mm。

螺钉 CAD 使用小径包络，孔轴表是构造数据，非完整螺纹制造定义。采购标准、等级、公差、扭矩与装配顺序须经工程审查后才能下发。
