snsnnd/li_ku/CoreXY整体重构_C03_先读我.md

# C03 — 整体重构为底部CoreXY＋Z升降＋固定双叉

- **[优先打开：完整纯实体兼容STEP](model/CoreXY_Fork_MVP_C03/viewing/CoreXY_Fork_C03_SOLIDS_AP203.step)**
- [整机工程图PDF](model/CoreXY_Fork_MVP_C03/drawings/CoreXY整机重构_C03_工程图.pdf)
- [结构预览](model/CoreXY_Fork_MVP_C03/previews/C03_structure.png) · [A/B皮带绕法](model/CoreXY_Fork_MVP_C03/previews/C03_AB_belt_paths.png)
- [完整机械设计包ZIP](model/CoreXY_Fork_MVP_C03/CoreXY整机重构_C03_机械设计包.zip)
- [说明/打印/采购](model/CoreXY_Fork_MVP_C03/README.md) · [未完成项](model/CoreXY_Fork_MVP_C03/采购补充与未完成项.md)

两台A/B电机固定底座，CoreXY驱动双梁承载小车；第三台ZDT驱动金属丝杆Z塔；上部不再设置独立Y推拉驱动，改固定钢叉和叉槽货位。净货载目标1kg，不覆盖E01/E02/V03.1/M01。

**这是整机架构/机械设计评审交付，不是可直接制造/上电的成品。** 实际皮带夹齿、张紧锁紧、肩轴叠层/驱动轮轴向保持、全部紧固/公差、自动防下滑、电气安全和A/B协调固件仍需继续工程化。
