snsnnd/li_ku/文档/CoreXY_EP_V3_参考评估.md

# 【大鱼DIY】雕绘仪 EP V3.0 — 立库底部XY参考评估

## 查阅范围

参考目录：`D:\tmp\【大鱼DIY】雕绘仪 EP V3.0 全套资料`。

已读取整机照片、采购表、总装STEP及电机/横梁/转接支架等分件STEP。总装经OCCT导入为166个有效实体；仅作文件几何读取，不代表实机承重或当前CAD软件显示验收。

未运行资料中的EXE，未刷写BIN，也未修改参考资料、E01或E02模型。

## 机构识别

这是适合研究的 **CoreXY式耦合平面机构**，不是E02那种两套独立轴皮带：

- A/B两台平面电机固定在外框两侧，不跟笔架或横梁移动。
- 两条独立皮带处于不同高度层，经固定/移动惰轮绕行，驱动横梁与其上的工具小车。
- 导轨/滑块承担工具重量和力矩，皮带负责驱动力，不承担竖向支承职责。
- 一台电机不独占一个几何轴。常见坐标约定下，带位移A=X+Y、B=X-Y；具体符号、倍率及张紧后的实际带路需在新设计里验证。
- `corexywifi.bin`文件名与这一判断相符，但不能据文件名认为该固件可直接控制现有ZDT；最终控制模式/接口和协调轨迹尚未核实。

总装中两条带的有效包络分别位于CAD的Y=-7.5..-1.5及Y=1.5..7.5，带宽6mm、层中心相距9mm；A/B电机位于外框同一端的两侧。尺寸是参考模型读数，不是立库新方案的选型值。

## 采购表确认的参考规格

- 标称工作行程220×300mm。
- MGN12 270mm＋12H滑块：1套；MGN12 350mm＋12H滑块：2套。
- MGN9 55mm＋9C：1套，用于短抬笔机构，不是承载立库的Z升降导向。
- 2020型材338mm×2、460mm×2；1020型材300mm×1。
- 平面驱动轮20T、5mm孔、6mm带宽×2；带齿惰轮同规格×2；F695ZZ×20；GT2-6mm开口皮带5m。
- 步进电机共3台，另有四氟管/气动接头/自行车刹车钢丝等抬笔传动材料。

这些是历史资料描述，不是现时可直接下单或匹配ZDT的采购确认；价格、链接可用性、带轮/轴承和电机能力都未验证。

## 必须注意的资料内不一致

总装STEP与采购表不能当成完全一致的制造版本：

| 项目 | 采购表 | 总装STEP几何读数 |
|---|---|---|
| 两侧长导轨 | MGN12 L350 | 两条侧轨实体均长270 |
| 侧向2020型材 | L460 | 两条侧向型材实体均长380 |
| 横向2020型材 | L338 | 横向型材实体长340 |

STEP中部分产品名称还写有`Y轴353mm`、`X轴330mm`等，与其几何尺寸也不完全一致。因此应借鉴运动拓扑，重新参数化立库尺寸，不能照文件名、表格或不同版本混合下料。

参考STEP的框架平面主要在CAD的X/Z平面，法向是Y，不能把该文件的Z直接当成立库升降轴。移植到立库水平XY平面时需明确坐标变换和装配基准。

## 建议的新立库架构（尚未建立新CAD）

```text
固定底框：A/B两台现有ZDT + CoreXY双层带路
  └─ 双侧导向、受支承的移动横梁
       └─ 带足够抗倾覆支承跨距的平台小车
            └─ 第三台ZDT + TR8x2金属丝杆升降
                 └─ 固定短货叉/托架
```

这才实现“XY电机都固定在底部”，不需要在Z平台上保留E02的Y电机、侧置皮带、独立推拉头、夹爪连接臂及原料盒牵引销释放机构。Z电机/导向/支承仍随平面小车运动。

货位需要同步改为有叉槽的承托接口：进入料盒下方 → Z微升脱离货位 → 平面退出。微升量应根据支承/定位结构、实际误差和干涉确定，不在未建模时指定一个假定安全值。现有两块完整托板不能直接互相穿入。

## 可以参考与不能照搬的内容

**可以参考：** 两台固定电机、双层带路、横梁两端导向、惰轮布置/张紧思路、开口带的两端固定方式和CoreXY坐标变换。

**必须重做：**

1. 横梁和工具小车的承载结构。不能用原1020轻横梁、单笔架滑块和打印连接件，未经校核就悬挂立库升降架。
2. 平台抗倾覆：导轨/滑块数量、横梁刚度和支承跨距需按货物及整套机构质量、货叉悬臂和动态工况计算，不能只按1kg货物。
3. 大小车包络及有效行程。原220×300的笔尖行程在装上宽大的升降架后可能减少，不能直接认定够用。
4. 双带轮对中、同轴/错层惰轮、锁紧张紧、皮带夹和电机径向力；6mm皮带/20T只是参考，须按新运动质量重新选型。
5. CoreXY运动控制。两台ZDT需要协调的A/B轨迹，不是原来一台接收X目标、另一台接收Y目标。实际驱动接口和时序尚待确认。
6. 原抬笔机构不能作为1kg升降机构复制。保留/重做金属Z承力系统、独立防下滑、维护支撑及限位/门禁/急停。

## 结论

**建议把这套CoreXY平面拓扑作为下一版架构的首选比较对象，先做承载横梁/小车、Z塔与货位的整体布局，再决定是否取代E02。**

它符合“两台XY电机固定底座”的目标，也有机会减少上部机构；但并不意味着现成雕绘仪可以直接承载立库，或在尚无计算/试验时就已经比其他架构最优。

本次交付为参考评估，不是新架构已完成的CAD、制造放行或1kg带载运行许可。
