snsnnd/li_ku/文档/V02_安全与验收.md

# V02 安全设计、采购冻结与验收

状态：**结构原型；制造/运行放行 BLOCKED**。本文件是工程要求，不是安全认证，也不声称达到某个PL/SIL等级。

## 1. 已在模型表达的措施

- Z低导程金属丝杆、工作螺母、备用铜螺母、0.8 mm轴向捕获间隙。
- 备用螺母有两只防转肩销，不能随丝杆空转；捕获钢笼底厚5 mm，以四处M3连接钢桥。
- 固定端正向2.5 mm横销、径向/推力轴承分工、轴承台阶/垫圈/端盖、浮动端。
- 失电制动电机的安装包络，不默认丝杆自锁。
- 三轴机械挡块和同步带张紧座。
- 牵引销回位弹簧、导向衬套、轴环、钢滚销及挡圈接口。
- 格口后挡边，限制料箱误推过深；正面设防护门，其余面为防护板。
- 连续金属底板、前后货架立柱、抗剪板和可锚固底脚。

**尚未选定的商品和控制线路，画出包络不等于已经安装或通过测试。**

## 2. 必须采购/冻结的接口

| 项目 | 冻结要求 | 当前状态 |
|---|---|---|
| TR8×2丝杆 | 单头、金属，按图加工Ø6支承段/配合横孔；材料屈服≥500 MPa，供应商确认横孔对强度与疲劳的影响 | 待供应商确认 |
| 正向横销 | Ø2.5×16，可靠轴向留置；供应商双剪能力≥2500 N，不能用打印销或无牌软铁丝 | 待证明 |
| 固定端轴承 | 626、F6-12M的实际图纸、配合、预紧、钢垫片和安装工艺 | 待确认 |
| 电机及制动 | 转矩曲线满足需求；失电抱闸≥0.3 N·m，核对释放/吸合延时及动态制动能力 | 未选定型号 |
| 主/备用螺母 | 同导程，法兰孔16 mm节圆；装配相位、间隙、磨损判据和润滑方案 | 待实物 |
| 导轨与滑块 | MGN12H与MGN9H真实厂家CAD，端封/油嘴/安装螺纹及旋入深度；双轨平行度与安装面平面度 | 待冻结 |
| 3030/2020 | 真实槽型、中心孔、端部攻丝规格与配套槽螺母；不得把简化方块当标准截面 | 待冻结 |
| 舵机 | 金属齿，真实输出轴坐标、花键/舵盘厚度及150°可用角度，托架不得压伤壳体 | 待实物匹配 |
| 回位弹簧 | OD7、自由长约19、压实≤1.8 mm，锁定态回位力约0.2 N、释放端约1.2 N；必须测力/测压实 | 待确认 |
| GT2皮带/轮 | 6 mm宽、20T、定长1420/404 mm或另行复核开口带夹持；从动轮必须有真实轴承和挡圈 | 待采购确认 |
| 防护与门锁 | 3 mm PC只是厚度候选；冲击和夹伤风险评估，门铰链、锁扣、防护安装及安全联锁图纸 | 待工程评审 |

## 3. 运行前必须完成的控制/电气设计

不允许用普通上位机程序或AI/MCP当安全控制器。本项目当前没有控制器固件或安全接线实现。

1. 外部急停、安全门开关、独立安全继电器/合适的安全控制器。普通运动MCU只读取状态，不得是唯一切断路径。
2. X/Z/Y每轴回零传感器和正负硬限位，共至少9路位置开关；机械挡块不替代电气限位。
3. 夹销上/下到位、托盘有箱、目标库位有箱检测。运行时保持销啮合，缺少反馈应停机，不凭步数推断。
4. 制动释放顺序：电机建立保持能力→确认制动释放→允许Z运动。停车反向执行；制动是否允许作为动态急停需按厂家说明。
5. 突然掉电时自动失电制动，但必须实测最大下滑量。制动不能防丝杆断裂；备用螺母也不能防丝杆/支承整体断裂。
6. X/Z移动只允许Y处于经实物标定的完全收回区，禁止三轴未经验证的同时运动；每次取放超时或失步均需重新确认位置。
7. 存箱要求目标空、托盘有箱；取箱要求目标有箱、托盘空。释放后撤回取放头，不能把料箱一起带走。
8. 电流/转矩限幅只作为功能保护，不是经过认证的夹伤力限制。Y初调目标拖动力≤12 N，超限停机调查卡滞，不继续增大电流硬推。
9. 电源分支保险、PE接地、24V与舵机稳压支路、驱动器温升、线缆最小弯曲半径和拖链。线缆完整路由尚未建模，应留制造放行项。
10. 自动模式关门；维护断电挂牌并装独立机械支撑，不能只按下急停后伸手进入Z下方。不得让普通保持抱闸承担人员防护的全部责任。

## 4. 初步失效模式与控制

| 失效 | 影响 | 设计/要求 | 仍需证据 |
|---|---|---|---|
| 掉电/驱动器关闭 | Z下滑、夹销状态丢失 | 失电制动、回位弹簧、防护与受控重启 | 热态/冷态最大下滑量、反馈联锁 |
| 工作螺母磨损或断裂 | 搬运器下坠 | 防转备用螺母+0.8 mm间隙捕获 | 冲击下钢笼、四M3、丝杆、横销、推力轴承完整链路试验 |
| 丝杆或固定端断裂 | 备用螺母无效 | 人员隔离、防护封闭、维护机械支撑 | 若要求单故障下保持载荷，另选独立导轨制动/防坠器并重新布局 |
| 皮带松脱/夹带滑移 | 位置失真、撞端 | 可调张紧、锁紧、独立限位和机械挡块 | 带张力、夹持拉脱试验、失步恢复逻辑 |
| 销未插入或未退出 | 拉空、撞耳、拖坏料箱 | 锥尖、衬套、机构回位、到位/有箱检测 | 逐箱误差与偏摆试验、孔间隙标定 |
| 打印件蠕变/磨损 | 高低差、卡滞、销位漂移 | 金属主受力路径、可换打印磨损件 | 满载静置、循环、温升后的复测 |
| 库位过推 | 箱体滑出 | 后挡边、占位检测、力限幅 | 挡边强度和失控工况 |
| 框架侧摆/台面倾覆 | 对位偏差、整机危险 | 前后立柱、抗剪板、四点锚固 | 节点刚度、空载/满载偏载、台面及锚固验算 |
| 防护门打开仍运动 | 人员进入夹点 | 独立联锁切断、制动及安全重启 | 完整安全回路测试，不接受只测GUI状态 |

## 5. 未建模/未放行补充BOM

`model/V02/BOM.csv`不是完整采购清单。至少还应包括：

- M3/M4/M5/M6/M8螺钉、配套锁紧螺母、平垫、限位螺钉及螺纹防松；逐条连接核对长度和旋入深度。
- 型材标准金属角件及槽螺母。货架底脚M5中心连接和四角长螺钉已布孔，但型材框架其他标准角件、面板安装件并未全部建模。
- 方管抗压套、打印托板的金属垫圈/嵌件、滚销卡簧、轴承压盖和精密调整垫片。
- 限位开关支架、撞块、门联锁、急停、继电器、控制器、驱动器、保险、电源、线束、拖链。
- 防护门铰链/门扣、10 mm面板间隔柱、防护板紧固件、独立机械维护支撑。

这些零件需要厂家图纸和装配工具空间。**不能因为补充BOM列了名字就标为实体干涉已通过。**

## 6. 分阶段验收

### A. 加工前

- 核对所有报告指纹与当前模型相同。
- 完成供应件冻结、孔的加工/攻丝/沉头/沉孔图、公差、螺钉长度和装配顺序。
- 做导轨并行/平面度、取放高度、公差链、螺钉头及工具完整检查。
- 对备用捕获的1.2 kN工况、横孔轴疲劳、钢笼局部弯曲和节点连接做工程复核。
- 分析丝杆临界转速和支承刚度；按最低能满足需求的速度试车。

### B. 单件和单格试验

- 先打印1个箱、1个格口、1套末端和夹带试块，不能直接打20套。
- 测导向内宽、底面翘曲、牵引孔实际直径、销顺滑性、两平台高低差。交接高低差初始目标≤0.3 mm。
- 试验143 mm箱移和含间隙的真实电机行程，记录推/拉差异，确认到位传感器和弹簧不压实。
- 标定舵机15°～165°端点；断电能否可靠落销不能只手感判断。

### C. 装机后

- 先无电手动、再单轴空载、再空箱，最后逐级加载0.25/0.5/1 kg。
- 每个库位进行存、取、空位/有箱异常、未插销/未退销、超时、失步和限位失效试验。
- 初始回零重复性目标≤0.2 mm、库位重复定位目标≤0.5 mm、承托面总挠度目标≤0.5 mm；这些是待验证目标，不是当前已达到值。
- 断电下滑和备用捕获单独在封闭、无人接近的专用试验条件下进行；不得让人用手接坠落部件。
- 完成20库位全载、最不利偏载、热稳态及至少1000次循环后再确定维护周期。试验失效须回到设计阶段，而非在报告里降低门槛。

在A、B、C及安全回路验收前，保持 `hardware_accepted=false`、`release_allowed=false`。
