snsnnd/li_ku/model/Belt_1Cell_MVP_E02/E01_E02优化对比.md

# E02相对E01的结构优化

- XY齿条、齿轮、金属背板、长支承脚及自制轮毂取消，改金属带轮+采购GT2同步带。
- X电机固定底座，不再拖动电机和大后伸安装结构；X移动板由160×160减至160×120。
- Y电机固定在Z平台下方，推拉头不再携带0.5kg假定电机质量和外伸支架。
- Y导轨中心距26→52mm；轨/头底座降低6mm，保留原料盒和锁销基准。
- Y皮带侧置，固定电机不侵入存取通道；轻连接臂只带夹爪，不带电机。夹爪须匹配实带齿形。
- 底板610×650→610×590mm，深度减少60mm（9.2%）；防护罩和独立IO保留。
- Z丝杆、双螺母、金属主承力路径保留，不因轻载取消安全需求。

## 相同1kg货载、自重密度及余量假设下的比较

|轴|E01运动质量kg|E02运动质量kg|E01所需扭矩SF2 N·m|E02所需扭矩SF2 N·m|
|---|---:|---:|---:|---:|
|X|10.203|9.497|0.274|0.113|
|Y|2.240|1.653|0.440|0.154|
|Z|5.162|5.150|0.149|0.149|

以上是候选低速工况的估算，不是实测或电机合格判定。1kg是货物净质量，不含料盒和机构；Z仍需要搬动整个平台。

## 同步带的新增代价
- 需要实际张紧、对中、防松、齿形夹爪和惰轮轴承；柔性伸长及振动未动态仿真。
- 较低驱动扭矩不等于电机轴负荷更小：预紧会增加径向力，必须核对实际ZDT轴承/轴端能力。
- engineering_checks.json中的15N预紧只是算例，不是张紧操作值。带规格、张力和匹配齿形须向供应商确认。
- 两条同步带暂定闭环GT2-1000-6及GT2-400-6；不能买不到就直接换任意长度/带轮，应先调整中心距并重验行程。
- 当前只做机械设计/几何验证，未完成自动存取固件及安全链。
