snsnnd/li_ku/model/Belt_1Cell_MVP_E02/采购补充与未选型项.md

# E02采购和加工前必须确认

`采购与金属加工清单.csv`为CAD实例数量，不是已经验证的生产采购套件。

## 主件

- 现有完整ZDT电机3台：实际5mm轴及安装31mm孔距、轴长/盲孔深度、电气参数、运行曲线、轴承径向能力须确认。
- 两条采购闭环同步带：GT2/2mm/6mm，节线长1000（X）和400（Y）。两只驱动轮20T/5孔、两只20T惰轮；光滑CAD包络不是制造齿形。
- 每只惰轮暂分配2×MR105ZZ（5×10×4），D5肩轴、内圈隔套/垫片及保持件；实际供应商装配结构必须替换候选包络复核。
- 金属带夹齿形需匹配实带。CAD浅直肋只示意2mm节距，不能直接拿来加工为GT2齿形；必须做夹紧、拉脱与寿命试验。
- X双MGN12 L400＋4长块；Z双MGN12 L250＋4长块；Y双MGN9 L200＋2长块、间距52mm。外形/端距/孔距/高度按实购件校核。
- Z金属TR8x2总长298，双金属螺母，626ZZ×2、F6-12M×2、候选5×6联轴器，延续E01配合和强度待审核项。
- 前端Y=-31：2×M4x60沉头穿过托盘＋2个钢压缩套6×4.5×21；后端Y=-217：2×M3x55圆柱头＋垫圈，从管顶穿过实心端塞。后端端塞竖向配作高度21压紧承托，只开M3通过孔，不能塞第二个压缩套/扩孔破坏原M5端部螺孔。四处各配下垫圈和螺母。

## 未选型或未完整建模的必需项

- 独立常闭制动/防下滑装置及其真实安装接口、断电/失控故障安全方案。
- 实际电源、熔断/短路保护、接地、急停、门禁/门锁、断能元件及驱动器相应接线。不能将电机使能等同安全急停。
- 六个轴端限位的真实开关、安装支架、触发片、归零/硬限位电路；当前仅空间候选。
- Z电机/平台、释放机构柔性线束、护线和应力释放；X电机固定后可减少一组随X运动的电机线，但仍有Z平台线束。
- IO门执行器/铰链/保持件、双门互锁、释放舵机实物参数和控制逻辑。
- 3030/2020实际T螺母、角码/端部连接、导轨基条/底板连接、IO立脚/框架、货位托板、丝杆螺母法兰/钢笼及顶端轴承栈等非逐颗建模紧固件。
- 上述连接必须按叠厚逐一选螺钉长度、有效啮合、盲孔余量、防松和工具空间，不能按CAD光滑孔径猜长度。
- PC板/门铰链、封边、锁扣和台面锚固；防护架不是轴系主承力架。

**尚未完成实物/安全验收。1kg属于轻货载，但不因此省略任何防下滑和安全措施。**
