snsnnd/li_ku/model/Powered_1Cell_MVP/采购补充与未选型项.md

# E01采购边界与补充清单

`采购与金属加工清单.csv`是CAD实际出现的实例数量，不是已经选定品牌或可以一键下单的全套生产BOM。

## 主要选型
- 现有ZDT完整电机3台；实测轴径/轴长/31mm孔距及盲孔深度，提供电气参数和运行曲线。
- MGN12双轨X400、Z250，各4个长滑块；MGN9双轨Y200，各1个长滑块。实际高度、孔距、端距以供应商图为准。
- TR8x2金属丝杆总长298，工作螺纹228；双金属螺母，Ø6加工轴颈；勿用TR8x8替换。
- 626ZZ 2个、F6-12M推力轴承2个；横销、定位套、配合作业和预紧必须审核。
- 联轴器5x6（Ø19x25空间），需有可靠夹紧和额定扭矩，不得打印替代。
- XY自制金属夹紧轮毂各1；角相位不同，分件STEP表示装配相位，不是不同轴孔。

## 尚未选型/未完整建模，不能遗漏
- 独立常闭制动/防下滑装置及实际安装接口、故障安全控制。图中候选包络并非可采购产品。
- 急停、安全门开关/门锁、接触器或合适安全断能方案、电源/保护接地、熔断/短路保护；应按实际驱动器接线规范设计。
- 6个轴端限位仅有候选体积：需要实际开关、安装支架、触发件、归零/硬限位接线及动作距离校核。
- 线束、拖链/柔性支撑、护线套、应力释放；Y电机和释放机构全行程线束未画。
- 柜门铰链/锁扣、PC板连接件、封闭缝隙和台面锚栓需实际选定。
- 型材角码/T螺母、轨道基条/底板、齿条/背板、IO立脚/框架、托盘/方管、螺母法兰/钢笼、轴承壳/顶板等连接的全部非建模螺钉、垫圈和压缩套。
- 这些非建模连接不能直接按孔径猜螺钉长度：需逐项核对叠厚、有效啮合、盲孔底部、工具可达性和防松。总装STEP主要电机/导轨/滑块/桥螺钉已建模，但不是全部紧固件。
- 除XYZ三台电机外，释放执行器、IO门执行器及相关控制仍需按继承机构实际选型，未提供自动程序。

**目前是机械设计评审交付，不是可直接制造/上电/1kg带载的整机放行。**
