snsnnd/li_ku/V02_先读我.md

# V02 立库工程原型

**已优化结构并生成模型；尚未制造/安全放行。V01原文件保留。**

## 先看这些文件

1. [结构优化与交付说明](文档/V02_结构优化与交付说明.md)
2. [安全、采购冻结和验收要求](文档/V02_安全与验收.md)
3. [整机STEP](model/V02/ASRS_Modular_V02.step)
   - 如果SolidWorks显示异常或防护板遮挡内部，先用[内部结构查看副本](model/V02/viewing/ASRS_Modular_V02_INTERIOR_VIEW.step)：扁平248实体，仅省略5块外罩板；不是制造模型。
4. [结构检查图](model/V02/previews/assembly_isometric.png)
5. [取放器伸出/释放检查图](model/V02/previews/pickup_extended_released.png)
6. `model/V02/delivery_audit.json`：独立产物回读、网格及报告指纹汇总。
7. `model/V02/native/solidworks_validation.json`：SolidWorks转换状态；只有明确成功才能视为本次原生文件已完成。

## 这版改变了什么

- X/Y同步带，Z金属TR8×2丝杆；双轨四滑块，真实装配高度和对应安装孔。
- 重做最低层和取放净空，消除撞板、滑块重叠、承托臂侵入箱底、取放立板穿托盘等问题。
- 料箱底面承重，改用竖直钢销牵引；打印曲柄/滑槽机构配金属销、衬套、轴环和回位弹簧。
- 加入金属方管承托、金属连接桥、前后立柱、后抗剪板、连续底板、张紧座及机械挡块。
- Z采用失电制动候选、带防转键的备用螺母、捕获钢笼和正向横销。防坠冲击仍须整链路试验。

## 当前证据与边界

- 91种模型零件，253个组件；有效零件/打印清单以`manifest.json`为准。
- 15项回归测试通过，包含夹带座STL封闭性回归。
- 2045个离散运动采样姿态无非预期实体碰撞，包含推/拉吃隙和释放后箱体留在库位的情况。
- 最终几何交付核验通过：整机STEP回读253个有效实体，91个单件STEP回读、10类打印STL封闭性检查及报告指纹一致性均通过，错误列表为空。证据见`model/V02/delivery_audit.json`。
- 原生装配核验未通过（转换未完成）；制造放行和实机验收仍为false。
- 原生输出属于导入B-rep＋固定审核姿态，不是已验收的原生运动配合/Motion Study。

## 必须接受的取舍

保留20库位、单箱1 kg，但外廓增加到约**786×546×769 mm**。空机估计约43.6 kg，满载加附件余量约65.6 kg，不能直接用于普通办公桌。工作台承载、锚固、成本和体积需要确认。

**不能直接批量加工或通电无人值守运行。** 采购件真实图纸、完整加工公差/螺栓与工具空间、安全接线、冲击防坠、定位及耐久实测仍未放行。先做单箱、单格和单套取放器样件。

旧的中间生成文件若归档在`model/V02/superseded_generated/`，不要用于打印或采购；它们不属于当前manifest。

**SolidWorks注意：** 原生转换中断，只保存了部分零件。按用户选择未重启/强制结束SolidWorks。COM断开导致临时模板及导入选项未能自动恢复，请下次使用时查看[设置确认说明](文档/V02_SolidWorks设置确认.md)，不要把部分原生文件作为整机交付。

工具来源与复现命令见[工具与复现](文档/V02_工具与复现.md)。
