snsnnd/li_ku/model/V03/viewing/README.md

# V03 模型查看文件

## 优先：ASRS_V03_LIGHT_VIEW.step

约6.7 MB，352个布局组件。省略17块外罩/门板；三个电机改为外形/轴包络，三个小齿轮改为外径圆环。真实齿条轮廓保留，重复零件复用定义，避免每个实例重复导出复杂实体。

**这是布局查看副本，不能打印、加工，也不能用简化轮廓验证真实齿形。** 权威整机STEP和`../stl/`中的打印文件没有被替换。

源模型指纹、简化清单、回读实体数及文件SHA见`light_view_readback.json`。SolidWorks实际打开与显示检查若完成，独立记录在`solidworks_light_check/`，不与几何回读混为一谈。

本次已在SolidWorks实际打开，设置Z轴朝上、带边线显示并缩放到整机；`solidworks_light_check/solidworks_view.png`已确认能看到模型。未修改系统偏好，未覆盖保存源文件。原来空白的具体根因尚未完全确定，不能把此次显示成功解释为已排除所有驱动/导入兼容性问题。

## 原细节：ASRS_V03_INTERIOR_VIEW.step

该文件只是去掉外罩，仍保留完整电机和细齿形，大小约64 MB。它并不是真正轻量版；导入慢或显示异常时，先使用上面的轻量布局版。

全模型位于上一级`ASRS_Modular_V03.step`。当前主设计仍是结构原型，制造/运行放行状态不因查看副本而改变。
