snsnnd/li_ku/V03_先读我.md

# V03：齿条驱动、适度模块化的迭代样机

**这是结构与接口原型，不是已经验收的整机，也不是全打印产品。V01、V02保留。**

## 看模型

- **[优先打开：轻量布局查看版](model/V03/viewing/ASRS_V03_LIGHT_VIEW.step)**：约6.7 MB，省略外罩，简化电机细节与小齿轮；仅看布局，不能用于加工或打印。
- [整机 STEP](model/V03/ASRS_Modular_V03.step)：含外罩、独立取放窗口及全部候选件。
- [完整细节内部结构版](model/V03/viewing/ASRS_V03_INTERIOR_VIEW.step)：只去掉防护板，仍约64 MB，不是轻量版。SolidWorks导入压力较大时不要先打开它。
- [整机结构图](model/V03/previews/assembly_isometric.png)
- [移动机构与本地电源盒](model/V03/previews/moving_module.png)
- [独立取放窗口](model/V03/previews/io_station.png)
- [独立货架列](model/V03/previews/one_column.png)
- [含门板的窗口检查图](model/V03/previews/io_station_enclosed.png)
- [本地电源盒内部预留](model/V03/previews/power_node_open.png)（分解检查图：盒体/托板下移60 mm，仅为看清候选电池和控制器）

预览来自真实CAD网格，**橙色表示尚未选型的电池、减速器、制动器或摄像头候选件**，不能按橙色包络直接采购。查看版隐藏外罩不表示允许运行时拆掉防护。

## 本次核验结果

- 123种模型零件、369个组件；整机STEP回读438个有效实体（完整电机各自包含24个实体）。
- 22类打印STL通过封闭性、单连通体及尺寸范围检查；23项回归测试通过。
- 1097个离散运动采样位姿通过保守空间检查，包含全部20库位、IO窗口及内门行程；真实齿形与拼接相位另有实体回归。
- 最终文件核验错误列表为空，报告与当前几何指纹一致。制造/运行放行仍为false，不能据此带载运行。

## 对应本次五项需求

1. **X/Y/Z均改为分段打印齿条＋打印小齿轮**。统一模数1.5、压力角20°、20齿小齿轮；每段齿条24个齿距，理论长度约113.097 mm。金属承载轨道、轮毂和独立防坠不改为打印件。
2. **使用您提供的完整ZDT电机模型**，包含后驱动板和接插件；三个轴分别预留随动电池/ESP32盒，采用本地短线接电机和传感器。
3. **适度模块化**：独立四立柱货架列、圆孔＋长孔定位底座、可拆取放头、统一电源盒及分块底板。不是所有连接都已完成快换工程化。
4. **独立IO窗口**：位于左侧，不占20个存储库位。包含通向外罩外侧的取放通道、外门、内升降门、固定遮挡板和有箱传感器预留。两门不能同时开放。
5. **视觉预留**：料盒正面偏左设可更换32 mm标签卡位，取放机构预留摄像头及调整架，各列另有固定参考标记。已提供25张官方AprilTag36h11码图和定尺寸打印页。

## 先确认的代价

- 为容纳独立列、IO窗口和随动电源，整机外廓约 **1.26×0.60×0.77 m**，比V02更宽；这不是紧凑化版本。
- 当前质量初筛约 **67 kg空机、89 kg满载含附件余量**，包含多项候选重量假设，最新值以`engineering_checks.json`为准。需要专用工作台与锚固复核，不能当普通办公桌设备。
- 随动电池和电机增加搬运质量；Z暂按10:1、Y按3:1减速器候选布置。它们尚未选型，也未证明实际电机转矩曲线满足要求。
- 齿条可分段，不等于导轨可以随意拼接。当前X导轨仍是1050 mm整轨，运输时需要保留这一长轴单元。

## 能否现在打印？

**可以先打印齿条啮合试块、一个料盒/格口、一套取放头及一个电源空壳进行手动试装；不要直接批量打印整机零件。**

- 打印文件位于`model/V03/stl/`，有效清单见`manifest.json`。
- 打印齿条背面朝下、齿朝上；不要沿装配姿态把Z齿条或细长导槽竖着直接打印。
- 禁止把电机、减速器、金属支架和制动器的STEP候选包络打印后当成承载采购件。
- **Z轴打印齿承重、防坠及电池供电尚未放行，不能带1 kg负载自动运行。**

## 无线和视觉的边界

无线不等于无接线，也不等于安全急停：本地驱动、传感器、稳压和制动仍要接短线。普通ESP32/Wi-Fi不是安全级无线联锁。电池节点也不会因为切断主机电源就自动断电。

目前交付的是控制接口要求及可执行逻辑测试，**没有ESP32固件、无线控制实机、摄像头识别程序或已验证的安全回路**。视觉应采用“回零/粗定位＋标记精定位”，不能只凭一次二维码识别就忽略限位和校准。

详见：
- `model/V03/module_interfaces.json`、`vision_layout.json`、`wireless_contract.json`：机械接口、标记初始位置和控制要求，均不等于已实现固件。
- [结构、接口与扩展说明](文档/V03_结构与模块接口.md)
- [无线、IO窗口和视觉要求](文档/V03_无线窗口与视觉.md)
- [打印、验证和放行清单](文档/V03_打印验证与放行.md)
- [最终产物核验报告](model/V03/delivery_audit.json)

若SolidWorks默认等轴测把模型显示为侧躺，这是Z-up模型与其默认视角的差异，不代表结构错位。可先看上面的检查图；不要为了观看而覆盖保存原始STEP。
