snsnnd/li_ku/model/CoreXY_Fork_MVP_C03/采购补充与未完成项.md

# C03采购、加工与控制的未完成项

本版CSV为CAD出现的实例数量，**不是可一键下单的已选型生产BOM**。机械架构重构不等于制造/安全放行。

## 核心采购参考

- 现有ZDT完整电机3台：A/B固定轴向上、安装面Z78，Z电机在移动塔顶。确认实物轴长、孔距/盲孔深度、接口和运行曲线。
- 开口GT2同步带两条、6mm宽，两个独立高度层。`validation.json`的A/B自由带路长度不是切断长度：需加真实夹持段/调节余量，先完成张紧设计再订长度。不得按旧E02闭环1000/400直接买。
- 金属20T驱动轮2个，下置轮毂5mm孔；B层只有约6mm轴向啮合空间，须厂家确认可靠夹紧/轴向保持，不能以光滑孔包络当合格零件。
- 每条带4个转向惰轮，总8个，按2×MR105分配轴承空间；两侧移动惰轮上下共轴，每侧一根肩轴和对应内圈隔套。肩轴、止退和实际叠层待供应商确认。
- MGN12 Y L400×2+4长块；X L440×2+4长块；Z L250×2+4长块。长块、轨道端距/孔距、高度与额定力矩按厂商图重新确认。
- 横梁500×40×60×4金属矩形管2根、3030长350×2、金属端板/小车板、连续金属底板660×680×8。轨座平面度与焊接/加工方案须签审。
- 两根钢叉18×8、有效伸出165、中心距56，与130×8×76根板焊接；完整插入后叉尖避开后挡块2mm。需焊缝、根板/螺钉和挠度复核，不能用打印叉。
- Z TR8x2金属丝杆/双螺母/626ZZ×2/F6-12M×2/候选5×6联轴器延续E01支承几何，实际加工端、公差、横销定位套、预紧与额定推力仍未验收。

## 机械细节仍需设计，不只是“买几个五金”

1. 四个带端夹的真实GT2齿形压板、可调螺纹张紧器、锁紧防松及拉脱/疲劳试验。当前端夹包络未定义完整制造细节。
2. 固定转向轮的张紧可调接口/槽和接收螺钉、动态带路最大张力和电机轴径向力验算。数学恒带长不能代替张紧设计。
3. 采购下轮毂驱动轮、惰轮内圈/外圈配合、肩轴长度、隔套和保持件。光滑外形不能作为制造GT2齿形依据。
4. 全部塔脚/型材T螺母、轨道基条/底板、箱梁/端板、顶端轴承栈/螺母法兰/钢笼、货位轨/承托角/立脚、防护框/PC板连接紧固件。
5. 所有孔轴表仅描述构造包络；实际攻丝、沉头、工具可达性、有效啮合、盲孔余量、公差和防松需逐项核对。不能按STEP光孔猜螺钉型号/长度。
6. 台面全支承、锚固、框架方正/平面度及四长滑块对中。大跨度的抗倾覆不能由打印笔架经验代替。

## 货位与控制

- 新无牵引眼料盒与叉槽承托轨，需真实打印底面、载荷分布、定位挡块及叉入/微升余量试验。8mm/4mm只是当前几何值。
- 独立自动防下滑/常闭制动、维护销状态确认；当前候选制动包络不是实际产品。
- IO双门互锁、门执行器/铰链/边缘保持及手部可达性；门模型不代表安全认证。
- 实际电源/熔断/接地/急停/安全断能、限位实体/支架/触发片与归零顺序。
- A/B协调驱动接口和时序、XY与Z运动联锁、坐标转换、异常停止和柔性线束。没有刷写雕绘仪固件，也没有提供经实机验证的控制程序。

**在这些项目完成前，禁止将1kg设计目标理解成可以直接带载运行。**
