snsnnd/li_ku/model/Manual_3Axis_MVP/五金清单.csv

规格 | 数量 | 用途
M3x16 内六角螺钉 | 50 | 齿条24、立柱底脚4、立柱背板4、Y角座立面4/托面2、承托支柱8、取放头4
M3x25 内六角螺钉 | 12 | 三轴端挡，各轴4
M3x20 内六角螺钉 | 6 | 三轴齿轮与手轮，各2；已建模
M3x12 内六角螺钉 | 32 | X底座4、库位脚16、前横梁8、库位柱顶4
M3x10 内六角螺钉 | 16 | 底架拼接板；不能改成长螺钉顶住工作台
M3 六角螺母，AF5.5，厚2.4 | 116 | 配上述M3连接；螺母窝名义深2.6，不可换厚螺母强压
M4x16 90度沉头螺钉，头径≤9 | 8 | 移动托盘4、库位托板4；必须沉平
M4 六角螺母，AF7 | 8 | 承托盘与库位托板
M4x60 内六角螺钉 | 3 | 手动齿轮轴，已建模
Ø6外径/Ø4.2内径 金属光滑隔套 L40±0.1 | 3 | 齿轮轴承面；不能用螺纹直接磨打印孔
M4平垫圈，OD≤9，厚1 | 7 | 三轴轴端6、Z锁销1
M4普通六角螺母，AF7，厚3.2 | 6 | 每根手轮轴两颗对锁，不能把轴向转动件夹死；已建模
M4x70 半牙螺钉 + M4手拧保持螺母 | 1 | Z定位锁销；保持螺母只防脱，不预紧弯曲锁耳
M4x80 半牙螺钉 | 1 | 手动牵引销；去毛刺倒钝端部，导向处优先光杆
工作台夹具 | 4 | 前后夹紧底架；未夹紧禁止升Z
