snsnnd/li_ku/文档/零件参数表.csv

零件号 | 名称 | 数量 | 类型 | 材料 | 外形尺寸mm | 关键特征 | 打印方向 | 填充率 | 支撑 | 备注
ASRS-BIN-01 | 料箱 | 20 | 打印件 | PETG | 110×120×60 | 壁厚2.4；框形扣口外廓44×16、净开口36×8、前伸12 | 开口朝下平放 | 4层墙+15% | 无 | STL已验证封闭
ASRS-CELL-01 | 格口托轨 | 20 | 打印件 | PETG | 118×130×11.5 | 托板厚4；两侧导向条3×130×8；两个T槽插块6×12×6、Ø5.5孔 | 托板朝下平放 | 4层墙+20% | 无 | 单点M5锁紧
ASRS-TRAY-01 | 承托盘 | 1 | 打印件 | PETG | 118×130×11.5 | 中心12mm通槽；导向条同格口 | 托板朝下平放 | 4层墙+20% | 无 | 承托料箱
ASRS-TARM-01 | 承托臂 | 2 | 打印件 | PETG | 12×96×8 | 连接Z滑台与托盘 | 侧面平放 | 4层墙+30% | 无 | 悬臂支撑
ASRS-HOOK-01 | 拨钩 | 1 | 打印件 | PETG | 30×20×28 | 钩舌30×4×10；转轴孔Ø3.2沿X | 侧面平放 | 6层墙+40% | 需要 | 只拖动不承重
ASRS-BRKT-01 | 定位连接板 | 6 | 打印件 | PETG | 60×30×9.5 | 两个定位键4×8×4间距16；两个Ø5.5孔间距44 | 平放 | 4层墙+40% | 无 | 可插拔定位件
ASRS-XCAR-01 | X滑台板 | 1 | 包络件 | 铝合金/打印件 | 100×90×8 | 待补M5孔与定位止口 | — | — | — | V02补孔
ASRS-ZCAR-01 | Z滑台板 | 1 | 包络件 | 铝合金/打印件 | 90×8×90 | 待补M5孔与定位止口 | — | — | — | V02补孔
ASRS-ZPLT-01 | Z定位连接板 | 2 | 包络件 | 铝合金/打印件 | 90×40×6 | 待补M5孔 | — | — | — | V02补孔
ASRS-EXT-01 | 2020型材X600 | 4 | 采购件 | 6063铝 | 600×20×20 | 底座纵梁 | 不适用 | 不适用 | 不适用 | 配端盖与角件
ASRS-EXT-02 | 2020型材Y370 | 2 | 采购件 | 6063铝 | 370×20×20 | 底座横梁 | 不适用 | 不适用 | 不适用
ASRS-EXT-03 | 2020型材Z510 | 5 | 采购件 | 6063铝 | 510×20×20 | 货架立柱 | 不适用 | 不适用 | 不适用 | 单列扩展+1根
ASRS-EXT-04 | 2020型材X120 | 8 | 采购件 | 6063铝 | 120×20×20 | 层横梁 | 不适用 | 不适用 | 不适用
ASRS-EXT-05 | 2020型材Y130 | 5 | 采购件 | 6063铝 | 130×20×20 | 进深梁 | 不适用 | 不适用 | 不适用
ASRS-EXT-06 | 2020型材Z480 | 2 | 采购件 | 6063铝 | 480×20×20 | Z立柱 | 不适用 | 不适用 | 不适用 | Z模块整体
ASRS-LM-01 | MGN12导轨600 | 2 | 采购件 | 轴承钢 | 600×12×8 | X轴长导轨 | 不适用 | 不适用 | 不适用 | 禁止拼接
ASRS-LM-02 | MGN12导轨450 | 2 | 采购件 | 轴承钢 | 450×12×8 | Z轴导轨 | 不适用 | 不适用 | 不适用 | 禁止拼接
ASRS-LM-03 | MGN9导轨170 | 1 | 采购件 | 轴承钢 | 170×9×6 | Y轴导轨 | 不适用 | 不适用 | 不适用
ASRS-LM-04 | MGN12H滑块 | 6 | 采购件 | 轴承钢 | 45×27×13 | X向4+Z向2 | 不适用 | 不适用 | 不适用
ASRS-LM-05 | MGN9H滑块 | 1 | 采购件 | 轴承钢 | 20×30×10 | Y向1 | 不适用 | 不适用 | 不适用
ASRS-MOT-01 | 42步进电机 | 3 | 采购件 | — | 42×42×40 | X/Z/Y各1 | 不适用 | 不适用 | 不适用 | 建议≥0.4N·m
ASRS-MOT-02 | SG90舵机 | 1 | 采购件 | — | 23×12×23 | 拨钩升降 | 不适用 | 不适用 | 不适用 | 可换金属齿
ASRS-DRV-01 | 步进驱动器 | 3 | 采购件 | — | — | A4988/TMC2209 | 不适用 | 不适用 | 不适用 | 1/16细分
