snsnnd/li_ku/(list of files, cad)

Other CAD files:
model/Belt_1Cell_MVP_E02/Belt_MVP_E02_ASSEMBLY.step
model/CoreXY_Final_C04/CoreXY_C04_ASSEMBLY.step
model/CoreXY_Fork_MVP_C03/CoreXY_Fork_C03_ASSEMBLY.step
model/Manual_3Axis_MVP/Manual_3Axis_Assembly.step
model/Powered_1Cell_MVP/Powered_MVP_E01_ASSEMBLY.step
model/Belt_1Cell_MVP_E02/parts/B007.step
model/Belt_1Cell_MVP_E02/viewing/Belt_MVP_E02_SOLIDS_AP203.step
model/CoreXY_Final_C04/parts/F079.step
model/CoreXY_Final_C04/viewing/CoreXY_C04_SOLIDS_AP203.step
model/CoreXY_Fork_MVP_C03/parts/C089.step
model/CoreXY_Fork_MVP_C03/viewing/CoreXY_Fork_C03_SOLIDS_AP203.step
model/Manual_3Axis_MVP/parts/C02.step
model/Manual_3Axis_MVP/viewing/Manual_3Axis_SOLIDS_AP203.step
model/Powered_1Cell_MVP/parts/E096.step
model/Powered_1Cell_MVP/viewing/Powered_MVP_E01_SOLIDS_AP203.step
model/V03_1/ASRS_Modular_V03_1.step
model/V03_1/parts/Independent_Steel_Safety_Track.step
model/V03_1/viewing/ASRS_V03_1_INTERIOR_VIEW.step
stl/Rack_Cell_118x130.STL
model/Belt_1Cell_MVP_E02/parts/B029.step
model/CoreXY_Final_C04/parts/F011.step
model/CoreXY_Fork_MVP_C03/parts/C073.step
model/Manual_3Axis_MVP/parts/P07.step
model/Manual_3Axis_MVP/viewing/Manual_3Axis_VIEW_ONLY.stl
model/Powered_1Cell_MVP/parts/E135.step
model/V03_1/parts/MGN12_Rail_Z500.step
model/V03_1/viewing/ASRS_V03_1_LIGHT_VIEW.step
stl/Bin_110x120x60.STL
model/Belt_1Cell_MVP_E02/parts/B069.step
model/CoreXY_Final_C04/parts/F007.step
model/CoreXY_Fork_MVP_C03/parts/C087.step
model/Manual_3Axis_MVP/parts/P26.step
model/Powered_1Cell_MVP/parts/E021.step
model/V03_1/parts/Cell_124x130.step
stl/Y_Hook_30mm.STL
model/Belt_1Cell_MVP_E02/parts/B135.step
model/CoreXY_Final_C04/parts/F029.step
model/CoreXY_Fork_MVP_C03/parts/C063.step
model/Manual_3Axis_MVP/parts/P14.step
model/Powered_1Cell_MVP/parts/E123.step
model/V03_1/parts/Latch_Pin_D4x60.step
stl/Keyed_Bracket_60x30.STL
model/Belt_1Cell_MVP_E02/parts/B144.step
model/CoreXY_Final_C04/parts/F064.step
model/CoreXY_Fork_MVP_C03/parts/C031.step
model/Manual_3Axis_MVP/parts/P03.step
model/Powered_1Cell_MVP/parts/E036.step
model/V03_1/parts/Guard_Panel_X-351.5.step
stl/Carrier_Tray_118x130.STL
model/Belt_1Cell_MVP_E02/parts/B050.step
model/CoreXY_Final_C04/parts/F114.step
model/CoreXY_Fork_MVP_C03/parts/C037.step
model/Manual_3Axis_MVP/parts/H02.step
model/Powered_1Cell_MVP/parts/E076.step
model/V03_1/parts/IO_Outer_Door.step
stl/ZDT_X42_L48Motor.STEP
model/Belt_1Cell_MVP_E02/parts/B150.step
model/CoreXY_Final_C04/parts/F077.step
model/CoreXY_Fork_MVP_C03/parts/C041.step
model/Manual_3Axis_MVP/parts/P22.step
model/Powered_1Cell_MVP/parts/E037.step
model/V03_1/parts/IO_Inner_Shutter.step
model/Belt_1Cell_MVP_E02/parts/B065.step
model/CoreXY_Final_C04/parts/F111.step
model/CoreXY_Fork_MVP_C03/parts/C060.step
model/Manual_3Axis_MVP/parts/C03.step
model/Powered_1Cell_MVP/parts/E080.step
model/V03_1/parts/Y_Stop_24x4x10.step
model/Belt_1Cell_MVP_E02/parts/B110.step
model/CoreXY_Final_C04/parts/F014.step
model/CoreXY_Fork_MVP_C03/parts/C096.step
model/Manual_3Axis_MVP/parts/H07.step
model/Powered_1Cell_MVP/parts/E118.step
model/V03_1/parts/Z_Stop_Rear_Clearance.step
model/Belt_1Cell_MVP_E02/parts/B063.step
model/CoreXY_Final_C04/parts/F031.step
model/CoreXY_Fork_MVP_C03/parts/C074.step
model/Manual_3Axis_MVP/parts/P13.step
model/Powered_1Cell_MVP/parts/E052.step
model/V03_1/parts/Z_Rack_Backbone_12x30.step
model/Belt_1Cell_MVP_E02/parts/B062.step
model/CoreXY_Final_C04/parts/F091.step
model/CoreXY_Fork_MVP_C03/parts/C001.step
model/Manual_3Axis_MVP/parts/P19.step
model/Powered_1Cell_MVP/parts/E106.step
model/V03_1/parts/Servo_Horn_Interface_Envelope.step
model/Belt_1Cell_MVP_E02/parts/B020.step
model/CoreXY_Final_C04/parts/F052.step
model/CoreXY_Fork_MVP_C03/parts/C067.step
model/Manual_3Axis_MVP/parts/P23.step
model/Powered_1Cell_MVP/parts/E138.step
model/V03_1/parts/MGN12_X1050.step
model/Belt_1Cell_MVP_E02/parts/B042.step
model/CoreXY_Final_C04/parts/F117.step
model/CoreXY_Fork_MVP_C03/parts/C101.step
model/Manual_3Axis_MVP/parts/C04.step
model/Powered_1Cell_MVP/parts/E078.step
model/V03_1/parts/Guard_Panel_Y221.5.step
model/Belt_1Cell_MVP_E02/parts/B011.step
model/CoreXY_Final_C04/parts/F090.step
model/CoreXY_Fork_MVP_C03/parts/C100.step
model/Manual_3Axis_MVP/parts/P01.step
model/Powered_1Cell_MVP/parts/E122.step
model/V03_1/parts/Y_Spine_Metal_Spacer_Left.step
model/Belt_1Cell_MVP_E02/parts/B021.step
model/CoreXY_Final_C04/parts/F049.step
model/CoreXY_Fork_MVP_C03/parts/C014.step
model/Manual_3Axis_MVP/parts/P24.step
model/Powered_1Cell_MVP/parts/E087.step
model/V03_1/parts/Metal_Pinion_Hub_Z.step
model/Belt_1Cell_MVP_E02/parts/B057.step
model/CoreXY_Final_C04/parts/F058.step
model/CoreXY_Fork_MVP_C03/parts/C104.step
model/Manual_3Axis_MVP/parts/P05.step
model/Powered_1Cell_MVP/parts/E053.step
model/V03_1/parts/Battery_Candidate_85x65x42.step
model/Belt_1Cell_MVP_E02/parts/B123.step
model/CoreXY_Final_C04/parts/F097.step
model/CoreXY_Fork_MVP_C03/parts/C095.step
model/Manual_3Axis_MVP/parts/P17.step
model/Powered_1Cell_MVP/parts/E083.step
model/Belt_1Cell_MVP_E02/parts/B037.step
model/CoreXY_Final_C04/parts/F018.step
model/CoreXY_Fork_MVP_C03/parts/C010.step
model/Manual_3Axis_MVP/parts/P18.step
model/Powered_1Cell_MVP/parts/E121.step
model/V03_1/parts/Z_Rack_Support_104x8x12.step
model/Belt_1Cell_MVP_E02/parts/B067.step
model/CoreXY_Final_C04/parts/F066.step
model/CoreXY_Fork_MVP_C03/parts/C018.step
model/Manual_3Axis_MVP/parts/H06.step
model/Powered_1Cell_MVP/parts/E032.step
model/V03_1/parts/Servo_Cradle_Lid.step
model/Belt_1Cell_MVP_E02/parts/B109.step
model/CoreXY_Final_C04/parts/F043.step
model/CoreXY_Fork_MVP_C03/parts/C008.step
model/Manual_3Axis_MVP/parts/H08.step
model/Powered_1Cell_MVP/parts/E023.step
model/V03_1/parts/MGN12H_Z.step
model/Belt_1Cell_MVP_E02/parts/B115.step
model/CoreXY_Final_C04/parts/F094.step
model/CoreXY_Fork_MVP_C03/parts/C016.step
model/Manual_3Axis_MVP/parts/P21.step
model/Powered_1Cell_MVP/parts/E013.step
model/V03_1/parts/Latch_Crank_R7.step
model/Belt_1Cell_MVP_E02/parts/B010.step
model/CoreXY_Final_C04/parts/F085.step
model/CoreXY_Fork_MVP_C03/parts/C084.step
model/Manual_3Axis_MVP/parts/H01.step
model/Powered_1Cell_MVP/parts/E047.step
model/Belt_1Cell_MVP_E02/parts/B001.step
model/Belt_1Cell_MVP_E02/parts/B002.step
model/Belt_1Cell_MVP_E02/parts/B003.step
model/Belt_1Cell_MVP_E02/parts/B004.step
model/Belt_1Cell_MVP_E02/parts/B005.step
model/Belt_1Cell_MVP_E02/parts/B006.step
model/Belt_1Cell_MVP_E02/parts/B008.step
model/Belt_1Cell_MVP_E02/parts/B009.step
model/Belt_1Cell_MVP_E02/parts/B012.step
model/Belt_1Cell_MVP_E02/parts/B013.step
model/Belt_1Cell_MVP_E02/parts/B014.step
model/Belt_1Cell_MVP_E02/parts/B015.step
model/Belt_1Cell_MVP_E02/parts/B016.step
model/Belt_1Cell_MVP_E02/parts/B017.step
model/Belt_1Cell_MVP_E02/parts/B018.step
model/Belt_1Cell_MVP_E02/parts/B019.step
model/Belt_1Cell_MVP_E02/parts/B022.step
model/Belt_1Cell_MVP_E02/parts/B023.step
model/Belt_1Cell_MVP_E02/parts/B024.step
model/Belt_1Cell_MVP_E02/parts/B025.step
model/Belt_1Cell_MVP_E02/parts/B026.step
model/Belt_1Cell_MVP_E02/parts/B027.step
model/Belt_1Cell_MVP_E02/parts/B028.step
model/Belt_1Cell_MVP_E02/parts/B030.step
model/Belt_1Cell_MVP_E02/parts/B031.step
model/Belt_1Cell_MVP_E02/parts/B032.step
model/Belt_1Cell_MVP_E02/parts/B033.step
model/Belt_1Cell_MVP_E02/parts/B034.step
model/Belt_1Cell_MVP_E02/parts/B035.step
model/Belt_1Cell_MVP_E02/parts/B036.step
model/Belt_1Cell_MVP_E02/parts/B038.step
model/Belt_1Cell_MVP_E02/parts/B039.step
model/Belt_1Cell_MVP_E02/parts/B040.step
model/Belt_1Cell_MVP_E02/parts/B041.step
model/Belt_1Cell_MVP_E02/parts/B043.step
model/Belt_1Cell_MVP_E02/parts/B044.step
model/Belt_1Cell_MVP_E02/parts/B045.step
model/Belt_1Cell_MVP_E02/parts/B046.step
model/Belt_1Cell_MVP_E02/parts/B047.step
model/Belt_1Cell_MVP_E02/parts/B048.step
model/Belt_1Cell_MVP_E02/parts/B049.step
model/Belt_1Cell_MVP_E02/parts/B051.step
model/Belt_1Cell_MVP_E02/parts/B052.step
model/Belt_1Cell_MVP_E02/parts/B053.step
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
