snsnnd/li_ku/model/Manual_3Axis_MVP/viewing/打开模型说明.md

# 装配导入空白时

1. 先打开 **[Manual_3Axis_SOLIDS_AP203.step](Manual_3Axis_SOLIDS_AP203.step)**。这是不依赖装配树的AP203多实体零件版，保留93个实体、原始坐标和尺寸，不是带运动配合的装配体。
2. 如果使用SolidWorks，按 **F** 缩放全图，再按 **Ctrl+7** 等轴测。没有必要为此覆盖原文件或改全局设置。
3. 仍看不到时，请提供软件名称、版本及界面截图。当前交付仅完成文件回读和渲染，未在您的CAD会话中确认显示。

- [兼容STEP回读后渲染图](solid_part_readback.png)
- [整机查看用STL](Manual_3Axis_VIEW_ONLY.stl)：可用切片器辅助看外形，**禁止将整机网格作为打印文件**。

真正的打印文件仍在上级 `stl/`，各零件方向和数量未改变。原 `Manual_3Axis_Assembly.step` 也未覆盖。
