snsnnd/li_ku/(commit log)

2026-11-09 立库三轴原型CAD与验证证据
    [2020_Guard_X760.SLDPRT, 2020_Guard_X760.step, 2020_Guard_Y480.SLDPRT, 2020_Guard_Y480.step, 2020_Guard_Z720.SLDPRT, 2020_Guard_Z720.step, 2020_Rack_Z650.SLDPRT, 2020_Rack_Z650.step]
2026-11-10 完成C04机械收敛版及244姿态验证交付
    [BOM.csv, CoreXY_C04_ASSEMBLY.step, CoreXY_C04_SOLIDS_AP203.step, F001.step, F002.step, F003.step, F004.step, F005.step]
